mahruschow/team-pterodactyl/docs/README.md

# Team planning and handoff

## Team-name silkscreen update — October 21, 2026

Saadat Muyeen, Mahrus Chowdhury and Ryeed Zaman are now on the back silkscreen, with 2 mm text and 0.30 mm strokes. Fresh DRC, connectivity and schematic-parity checks report zero issues. All original PCB bytes are retained; only three text objects were added. The other eight Gerber layers match the prior geometry exactly, apart from export timestamps. Existing ERC evidence remains applicable to the unchanged schematic.

**Order the updated native PCB or fabrication ZIP. AISLER TCVOYNZG revision 1 is superseded and does not contain the names.** Two revision-upload attempts failed; the alternate upload form says an anonymous project is already in progress and requires login to save it. Sign in and upload the updated board, then inspect the bottom preview before ordering. No new AISLER revision or order has been created. Earlier statements below about revision 1 being the exact current PCB or ready for checkout refer to the previous checkpoint.

PCB bench holder: [CAD files and mounting instructions](../mechanical/pcb-holder/README.md) — STEP, printable STL, editable CadQuery source and preview. Uses the existing four mounting holes; physical fit remains unverified. This holder is separate from the future flight enclosure.

## First prototype scope and order checkpoint - October 21, 2026

**Current authority: [FIRST_PROTOTYPE_RELEASE.md](FIRST_PROTOTYPE_RELEASE.md).** PCB checks and AISLER upload/preview passed; project TCVOYNZG revision 1 is ready for checkout. FB1/SW1/SW2/J3 are selected for P1. The user explicitly excludes physical testing, flight qualification, subsequent redesign and casing from this phase; older statements requiring those before PCB fabrication are superseded. Assembly receipt/polarity checks remain part of building the prototype. No order placed. Updated known cost is USD 129.37 (15 price lines missing); entered mass 170.25 g (three missing). The provisional EUR board quote is separate.

**Current implementation — October 21:** Start with [RESUME_HERE.md](RESUME_HERE.md) and [COMPONENT_IMPLEMENTATION.md](COMPONENT_IMPLEMENTATION.md). Targeted component changes and the budget update are applied; fresh native checks pass. FB1 needs replacement and switch/header, harness, physical-fit and cold-test gates remain open. Earlier dated statements below are historical where superseded.

Start here when joining the project or resuming work. This directory contains the shared plan, current status, requirements, session notes and validation evidence. It travels with the repository; no previous chat or access to Saadat's computer is needed to read it.

## Reading order

Latest budget: [Power, cost and mass](POWER_COST_MASS_BUDGET.md) — lead's updated direction, checked calculations, source evidence, partial totals and battery-selection dependencies.

Latest PCB implementation: [GPS carrier integration](GPS_CARRIER_INTEGRATION.md) — all 51 footprints assigned and routed. Earlier missing-GPS entries below are historical.

**Meeting handoff:** [October 20 teammate meeting](TEAM_MEETING_2026-10-20.md) organizes completed work, outstanding tasks, team inputs, proposed owners and a decision log.

Latest implementation: [Sensor read validity](SENSOR_READ_VALIDITY.md) — checked sensor transfers/CRC, empty failed-data records, health/recovery behavior and sixteen host fault-test groups.

Previous firmware implementation: [Firmware reliability](FIRMWARE_RELIABILITY.md) — checked SD sessions/recovery, bounded BNO reset, cooldown, host failure tests and current build evidence.

Latest PCB implementation: [Layout review and cleanup](LAYOUT_REVIEW_CLEANUP.md) — ADC filter placement, I2C order, local ground stitching, readable silkscreen and validation.

Previous implementation: [Power routing](POWER_ROUTING.md) — regulator/5 V/sensor rails connected, test points relocated, fresh DRC and preservation evidence. GPS remains absent.

Previous implementation: [Regulator and GPS footprints](REGULATOR_GPS_FOOTPRINTS.md) — assigned regulator carrier, unassigned GPS comparison draft, source evidence, validation and remaining fit gates.

Read the [October 19 v4 design review](V4_DESIGN_REVIEW.md) for the historical independent checks, seven prioritized findings and Step 1–7 completion assessment. Hardware and firmware fixes remain open.

0. [What's done and what's left](REMAINING_WORK.md) — one-page progress table and to-do list by owner (lead, Saadat, teammate).
1. [Current status and resume checklist](CURRENT_STATUS.md) — where we stopped and the next concrete actions.
2. [Version-one requirements](V1_REQUIREMENTS.md) — agreed baseline, proposals and unresolved decisions.
3. [Development plan](DEVELOPMENT_PLAN.md) — the ten steps from imported baseline to tested hardware.
4. [October 18 session notes](sessions/2026-10-18.md) — work completed, decisions and limitations.
5. [Baseline review](BASELINE_REVIEW.md) and [native validation summary](validation/2026-10-18/VALIDATION_SUMMARY.md) — evidence behind the current issue list.
6. [Module connection and mechanical review](SENSOR_CONNECTION_MAP.md) — Step 3 pin map, power/pull-up review, footprint mismatch and remaining verification gates.
7. [Carrier footprint review](FOOTPRINT_REVIEW.md) — three native draft footprints, pad numbering, assembly assumptions and test evidence.

8. [Module assembly proposal and closure gates](MODULE_ASSEMBLY_PLAN.md) — candidate connectors, spacing calculation, symbol validation and M01–M04 evidence checklist.

9. [Teensy drawing comparison](TEENSY_MECHANICAL_REVIEW.md) — supplied PNG, matching nominal geometry, implemented SSW carrier and remaining fit/retention requirements.

10. [Open requests for the team lead](TEAM_LEAD_REQUESTS.md) — plain-language Steps 1–3 summary and the inputs needed to close Step 3 and approve placement.

11. [Placement and interference plan](PLACEMENT_AND_INTERFERENCE.md) — Step 4 draft floor plan, placement/routing rules, estimates and prototype test matrix.

12. [Power architecture and v4 schematic](POWER_ARCHITECTURE.md) — Step 5 legacy power findings, load budget, battery-agnostic architecture, schematic implementation and checks.

13. [v4 firmware](FIRMWARE_V4.md) — Step 6 logger behaviour, log formats, LEDs/controls, pinned build and what is untested.

14. [Draft v4 PCB layout](PCB_LAYOUT_V4.md) — Step 7 placement, ground planes, checks, render and what remains before routing sign-off.

## Directory contents

```text
docs/
  README.md                     Start here
  REMAINING_WORK.md             One-page progress and to-do list
  CURRENT_STATUS.md             Current handoff and next actions
  DEVELOPMENT_PLAN.md            Milestones and completion criteria
  V1_REQUIREMENTS.md             Requirements and decision register
  SENSOR_CONNECTION_MAP.md       Step 3 interfaces and mechanical review
  FOOTPRINT_REVIEW.md            Draft carrier library and approval gates
  MODULE_ASSEMBLY_PLAN.md        Connector/height proposal and closure record
  TEENSY_MECHANICAL_REVIEW.md    Teensy drawing comparison and carrier review
  TEAM_LEAD_REQUESTS.md          Inputs needed from the lead/team
  PLACEMENT_AND_INTERFERENCE.md  Step 4 floor plan, rules and test matrix
  POWER_ARCHITECTURE.md          Step 5 power design and v4 schematic record
  FIRMWARE_V4.md                 Step 6 firmware behaviour and build record
  PCB_LAYOUT_V4.md               Step 7 draft board record
  BASELINE_REVIEW.md             Repository/source/tool inventory
  sessions/
    2026-10-18.md                Session record
    2026-10-19.md                Step 4 session record
  reference/
    Budgets_2026-10-18.xlsx       Unchanged supplied parts workbook
    baseline_manifest_2026-10-18.json
    step3-source-manifest.json   Manufacturer CAD commits, URLs and hashes
    step3-cad-geometry.json      Extracted header/outline/hole coordinates
    step3-carrier-pad-map.csv    Carrier-to-manufacturer pad mapping
    step3-gps-cad-history.json   GPS CAD age/revision evidence
  validation/2026-10-18/
    VALIDATION_SUMMARY.md        Findings, triage and commands
    baseline-erc.json            Native schematic check report
    baseline-drc.json            Native PCB and parity check report
    schematic-netlist.xml        Native KiCad-exported netlist
    net-comparison.json         PCB/schematic pad-membership comparison
    step3-footprints/           Native coordinate check, fixture, DRC and SVGs
    step3-symbols/              Sensor pin-contract/GPS logical checks and SVGs
    step3-teensy/               Carrier check, positive/negative DRC fixtures and SVG
  validation/2026-10-19/
    step4-placement/            Draft placement fixture, separation checks, DRC and SVG
    step5-schematic/            v4 ERC, netlist comparison, BOM and PDF
    step6-firmware/             Teensy 4.1 build log
    step7-pcb/                  v4 board DRC/parity, separations, render and assembly PDF
```

## Keeping this handoff useful

- Update CURRENT_STATUS.md at the end of a work session: completed work, remaining issues, exact next action and tool limitations.
- Add a dated session note for substantial work. Record files changed, checks performed and decisions with their source. Use a suffix for multiple sessions on the same day if useful.
- Keep DEVELOPMENT_PLAN.md milestone status aligned with CURRENT_STATUS.md.
- Keep requirements and the D01-D10 decision register in V1_REQUIREMENTS.md. Distinguish team decisions from unapproved engineering proposals.
- Save new check reports in a dated validation directory and identify the source commit and KiCad version. Preserve previous reports for comparison.
- Follow the root README's branch and library rules. Do not commit editor lock files, local UI state, scratch copies or authentication data.
- Historical Gerbers and an audit report are not a fabrication approval. Do not infer a passing design from zero unconnected PCB items.

Historical paths and pre-commit statements in the baseline/session evidence describe that point in time. Use CURRENT_STATUS.md and Git history for the current state.
