mahruschow/team-pterodactyl/docs/validation/2026-10-21/first-prototype-release/drill-report.txt

Drill report for PTERODACTYL_v4.kicad_pcb
Created on 2026-10-21T18:14:28

Copper Layer Stackup:
    =============================================================
    L1 :  F.Cu                      front
    L2 :  In1.Cu                    in1
    L3 :  In2.Cu                    in2
    L4 :  B.Cu                      back

Drill file 'PTERODACTYL_v4-PTH.drl' contains
    plated through holes:
    =============================================================
    T1  0.300mm  0.0118"  (24 holes))
    T2  0.400mm  0.0157"  (1 hole)
    T3  0.710mm  0.0280"  (2 holes))
    T4  0.800mm  0.0315"  (41 holes))
    T5  0.850mm  0.0335"  (2 holes))
    T6  0.900mm  0.0354"  (8 holes))
    T7  1.000mm  0.0394"  (20 holes))
    T8  1.040mm  0.0409"  (75 holes))
    T9  1.100mm  0.0433"  (4 holes))
    T10  1.190mm  0.0469"  (4 holes))
    T11  1.500mm  0.0591"  (2 holes))

    Total plated holes count 183

Drill file 'PTERODACTYL_v4-NPTH.drl' contains
    unplated through holes:
    =============================================================
    T1  2.700mm  0.1063"  (10 holes))
    T2  3.200mm  0.1260"  (4 holes))

    Total unplated holes count 14
