mahruschow/team-pterodactyl/docs/sessions/2026-10-21.md

# October 21, 2026 — component research handoff

Saadat requested a fresh-chat handoff before continuing component finalization. The latest component research had not yet been saved or applied. Created RESUME_HERE.md and COMPONENT_FINALIZATION_RESEARCH.md, and refreshed the current documentation entry points.

Latest user direction: AISLER manufacturer; no spending cap; minimize practical mass without a hard mass ceiling; preserve current dimensions where compatible; choose battery/SD and exact components. Existing 3 h, -40 C, soldered sensor-header and no-telemetry requirements remain.

Research recommends four series Energizer L91 cells and Kingston SDCIT2/8GB industrial microSD. Pack holder/harness and cold runtime remain unresolved. Found -25 C JST-XH connectors unsuitable for a rated -40 C design; proposed Molex replacement requires a pitch/pad update. Proposed specific capacitors with corrected body outlines, AO3401A and other exact BOM candidates. See the research table for sources and confidence limits.

**No component-selection changes were applied to KiCad, firmware or the live workbook.** No new ERC/DRC run, physical test, purchase, commit or push occurred in this handoff. The previously uncommitted GPS/budget changes are preserved. Native schematic and PCB hashes were checked unchanged during this documentation update. Resume with the research and native-file inspection, then complete targeted edits and fresh validation.

## Component implementation continuation

Native v4 targeted edits are complete for the reviewed parts. 51 footprints / 246 segments / 25 vias retained; eight segments have bounded endpoint edits, four small nonmodule footprint moves, no changed pad nets. Fresh checks: 0 ERC, 0 enabled DRC, 0 unconnected, 0 parity; 32 nets and 35 no-connects verified. BOM: 47 individual reference rows, zero blank MPNs, four candidates (SW1, SW2, J3, FB1). Evidence is in `validation/2026-10-21/component-finalization/`.

L91 x4 with BH4AAW is the prototype pack candidate; Kingston SDCIT2/8GB is in the budget. Updated model: 1.618 W average, 3.568 W peak, 8.669 Wh provisional nameplate target for 3 h. Entered mass 170.25 g with three missing mass lines; known price $118.30 with 16 unpriced lines. Detailed path-loss screening flags startup risk at a 4 V loaded pack. No physical validation or purchasing occurred.

The following entries preserve prior checkpoints and are superseded by COMPONENT_IMPLEMENTATION.md where they conflict.

See COMPONENT_IMPLEMENTATION.md and current RESUME_HERE.md for applied changes and next gates. Battery holder rating resolved to BH4AAW candidate; complete pack/harness remains unqualified. No commit, push, purchase or external message.

## First prototype order checkpoint

User explicitly limited this phase to the first physical prototype: no cold/flight testing or subsequent revision gate before fabrication. Read FIRST_PROTOTYPE_RELEASE.md and updated RESUME_HERE.md. The four held board references were resolved, fresh checks passed, original routing/outline/module positions retained, and manufacturing exports audited against native drills. AISLER TCVOYNZG revision 1 successfully processed the saved board; top/bottom preview checked and 3 bare boards configured at 1.6 mm / 35 um / ENIG / green-white. Provisional anonymous quote EUR 51.37 net; account/shipping/tax/payment remain. Nothing ordered, committed or pushed. New evidence lives in validation/2026-10-21/first-prototype-release. Separate grouped board/offboard BOMs and assembly instructions cover one populated prototype. Budget updated to USD 129.37 known subtotal (still incomplete); PCB quote kept separately in EUR.

## Git publication checkpoint

User authorized committing all project work to saadat-dev, pushing it, then updating main. Collected the native design, local footprints, documentation, scripts, validation evidence, reviewed fabrication ZIP and current budget workbook. Scratch checkpoints/downloads and Python caches remain local and ignored. Added exact-byte Git attributes for the four validated native files so their recorded SHA-256 values survive checkout. No design or firmware change was made during publication. Check Git history and remote refs for completed push status.

## Optional PCB holder

At the user's separate request, created an open bench holder using the native H1-H4 positions: 90.17 mm spacing, 105.79 x 105.79 x 13 mm overall holder, 10 mm clearance above its 3 mm frame. STEP/STL, simplified reference-board assembly, editable CadQuery source, preview, geometry checks and hardware instructions are in mechanical/pcb-holder/. Single-solid STEP reimport and closed single-body STL checks passed; physical fit and full component/hardware clearance are not established. The user authorized pushing the holder to main. The PCB and firmware are unchanged.

## Team-name silkscreen update — October 21, 2026

Saadat Muyeen, Mahrus Chowdhury and Ryeed Zaman are now on the back silkscreen, with 2 mm text and 0.30 mm strokes. Fresh DRC, connectivity and schematic-parity checks report zero issues. All original PCB bytes are retained; only three text objects were added. The other eight Gerber layers match the prior geometry exactly, apart from export timestamps. Existing ERC evidence remains applicable to the unchanged schematic.

**Order the updated native PCB or fabrication ZIP. AISLER TCVOYNZG revision 1 is superseded and does not contain the names.** Two revision-upload attempts failed; the alternate upload form says an anonymous project is already in progress and requires login to save it. Sign in and upload the updated board, then inspect the bottom preview before ordering. No new AISLER revision or order has been created. Earlier statements below about revision 1 being the exact current PCB or ready for checkout refer to the previous checkpoint.
