mahruschow/team-pterodactyl/docs/sessions/2026-10-20.md

# October 20, 2026 — firmware SD and BNO reset recovery

Continued the authorized firmware reliability work after interruption, starting
from `e1663f7` on `saadat-dev`. The interrupted work had added storage source and
a local BNO library patch, but had not integrated or validated them.

- Integrated transactional required-file session creation, checked writes/syncs,
  best-effort close, retry in a fresh folder and persistent fault indication.
- Moved metadata writing into a separately checked function. Appended
  `storage_fault_total` to health rows and USB diagnostics; version 4.0.1-draft.
- Vendored Adafruit BNO055 1.6.4 with its license, bounded post-reset polling,
  reset-write/read checks and one enum conversion fix for the host compiler.
- Added IMU retry cooldown and `INIT_WAIT` rows; refreshed loop timestamps after
  blocking operations to avoid premature SD retry due to unsigned subtraction.
- Added host fault-injection tests against production code and updated current
  status, remaining work and the October 20 meeting handoff.

See [FIRMWARE_RELIABILITY.md](../FIRMWARE_RELIABILITY.md) and its dated validation
folder for commands/results/limits. Sensor transfer/CRC validity and GPS RMC
freshness remain open. No PCB edits, firmware upload or hardware tests.

## Sensor transfer/CRC follow-up after 5a22f0b

Saadat authorized the next step. Implemented checked BNO055 sample getters and
initialization writes, vendored MS8607 1.0.4 with its attribution/license notices,
and propagated reset, calibration PROM/CRC, configuration, conversion and
humidity-transfer/CRC failures. The logger leaves failed rows empty, updates
sensor health and recovers on successful sampling without reinitializing every
transient read failure. Five consecutive IMU failures still trigger reset.

The suite now compiles both actual drivers; the old fake MS8607 driver was removed.
Sixteen groups pass, including invalid-data rows, health/LED behavior, short reads,
CRC rejection, initialization faults, wrapper reuse, recovery and earlier SD/BNO
timeout regressions. Teensy build passes with zero warnings. Firmware is
4.0.2-draft. See SENSOR_READ_VALIDITY.md and the dated sensor-read-validity evidence.
GPS freshness and CSV analysis are next; no PCB changes or hardware tests.

## GPS footprint integration

**U5 is assigned, placed and routed in the current v4 board.** Saadat inspected the linked 2017 Adafruit CAD and reported that it is the same, authorizing use of the existing source-derived carrier geometry. This is user visual acceptance for integration, not manufacturer confirmation or a measured physical-fit result.

See [GPS_CARRIER_INTEGRATION.md](../GPS_CARRIER_INTEGRATION.md) for changes, complete zero-error check results and remaining fit/fabrication work. Existing 50 footprints and all routing were preserved; added U5, 13 segments and eight vias. Firmware unchanged. Reload the open KiCad board without saving its stale contents.

## Power, cost and mass budget follow-up

Saadat supplied the lead's instruction to prepare all three budgets and choose a battery; nothing is ordered and the package should be as small as functional. Read `New Budgets.xlsx` unchanged and recorded its SHA-256. It is a different payload's reference, so its pumps/heaters, two-hour requirement, 37 Wh pack and owned-part costs were not adopted.

Created a live three-sheet logger budget and reproducible builder, with manufacturer sources, explicit current/efficiency/mass allowances, incomplete-total guards and runtime scenarios. Calculated 1.494828 W average / 3.283791 W peak battery input; illustrative four-hour nameplate target 10.677339 Wh. Five module prices total $118.30, with 17 cost lines missing. Mixed published/estimated mass subtotal is 107.7 g, excluding three missing mass inputs. The 0.7 A PTC needs review against low-voltage input peaks and its trip/temperature curves.

Twenty-two baseline, perturbation, missing-input, zero-efficiency and restoration checks passed; no final formula errors. Rendered all sheets and source notes. Runtime/battery fields were restored to blank. Added POWER_COST_MASS_BUDGET.md and validation/2026-10-20/budget-check.json, updated handoff/requirements/team-request pages. No PCB or firmware edits in this budget follow-up; no export, purchase, commit or push. Next: team duration/temperature, SD selection, battery/power-path review and complete BOM quotes/masses before compact mechanical design.

## Confirmed runtime update

Saadat confirmed runtime is three hours. Recorded this as total powered operation in the live budget and creation source, requirements and handoff pages. Recalculation gives 4.484483 Wh consumption and 8.008005 Wh nameplate target with the existing proposed reserve/usable-energy assumptions. Checked the Power and summary target match and rendered the updated summary. Temperature, battery voltage/selection and PTC review remain open. No commit or push.

## Temperature and through-hole assembly decisions

Lead's -40 C battery minimum replaces the earlier -45 C screening assumption. Saadat confirms through-hole soldered sensors and custom casing CAD after the PCB layout is complete. Recorded soldered headers at breakout/carrier holes; exact header lengths, pin/drill fit, underside clearance and retention are still open. Existing sensor sockets/12 mm stack proposal is historical. Teensy/regulator mounting unchanged. Updated the live workbook and builder: temperature input -40 C; interconnect mass now missing instead of the obsolete 10.5 g socket allowance; partial mass 97.2 g with four missing lines. Checked these outputs and unchanged 8.008005 Wh energy target, and rendered affected regions. No PCB/firmware edits, battery selection, commit or push.
