mahruschow/team-pterodactyl/docs/sessions/2026-10-19.md

# Session notes — October 19, 2026

## Session scope

Continued on `saadat-dev` after commit 65b851e, which published the Step 3 draft package. Saadat asked whether Step 3 could be finished, then asked for a plain-language summary of Steps 1–3 and a list of inputs to request from the team lead, saved in the docs. After that, the work moved on to Step 4.

## Work completed

1. Rechecked public sources for exact PA1616D #5440 geometry: the product page, the Ultimate GPS guide downloads page, and the Adafruit-Ultimate-GPS and Adafruit_CAD_Parts repositories. The product page confirms the 34.2 × 25.3 × 11.4 mm envelope and the September 18, 2024 revision that added the coin-cell holder. The guide's fab prints and board files still cover only the v3/PA6H, USB Micro B and USB-C variants. No #5440 entry exists in the CAD parts listing. M01 cannot be closed from public sources. M02–M04 need the enclosure, hardware approval and physical parts.
2. Added TEAM_LEAD_REQUESTS.md. It holds a plain-language Steps 1–3 summary, Step 3 closure requests R1–R5, Step 4 placement requests R6–R9, Step 5 inputs and an answer log.
3. Step 4: inspected the legacy board read-only (97.79 mm square outline, four 3.302 mm holes 3.81 mm from each corner, 4 copper layers, 1.6 mm thick). Drafted a floor plan and wrote PLACEMENT_AND_INTERFERENCE.md: assumptions A1–A6, placement/routing rules PC1–PC15, magnetic-field and I2C bus/rise-time estimates, and test matrix T1–T11 with proposed pass criteria.
4. Added tools/build_placement_fixture.py. It copies only the legacy outline and holes into an isolated fixture, places the three draft carrier footprints and two planning boxes (GPS envelope, power region), runs native DRC and checks 17 edge, hole and separation rules. The first run found a real issue: the MS8607 reference text was clipped by the board edge. Moved the module 2 mm down. The final run passes all 17 checks with zero DRC violations and zero unconnected items. The PDF export was visually inspected, and overlapping placeholder labels were fixed.

## Findings worth sharing

- Routing supply current with its return directly beneath it matters more than distance for the BNO055. An unpaired 0.3 A conductor at 40 mm is about 1.5 µT (about 5 magnetometer resolution steps); paired over a plane it is under 0.01 µT.
- Estimated I2C rise time with only the two host-side 10 kΩ pull-ups is about 340 ns at about 80 pF. That is fine for 100 kHz but over the 300 ns fast-mode limit, so do not use 400 kHz without measuring.
- A sealed enclosure would give wrong MS8607 pressure readings. Outside-air temperature/humidity needs exposure; remote probes were excluded in D01.
- The GPS needs a sky-facing antenna and an RF-transparent lid. Flight orientation of the board is an open question (R6).

## What was not done

- No edits to the main schematic, PCB, imported libraries or firmware. No routing.
- No physical tests, measurements or purchases. No messages sent to the lead or Adafruit.
- Separation targets and pass criteria are proposals pending team review.

## Resume point

Use CURRENT_STATUS.md. Step 3 remains open at M01–M04. Step 4 is drafted for review. The next independent work is Step 5 power architecture and schematic, using PC6, PC11, PC13 and PC14, while lead answers R1–R9 are pending.

## Step 5 — power architecture and draft v4 schematic

Saadat asked to move on to Step 5.

1. Traced the legacy power design from the exported netlist (read-only). Findings F1–F6 in POWER_ARCHITECTURE.md:
   - Two regulator outputs are switched straight onto VCC with no OR-ing.
   - Nothing isolates Teensy VIN from USB power.
   - The status LEDs have no series resistors.
   - The voltage monitor reads regulated 5 V, not the battery.
   - There is no fuse or reverse protection.
   - The A17 net's purpose is unknown.
2. Confirmed Teensy 4.1 limits on the PJRC page: pins not 5 V tolerant, 4 mA per-pin recommendation, 250 mA external 3.3 V, cut the VUSB/VIN pads for external power. Confirmed the Pololu S9V11F5 page: 2–16 V in, 5 V out, 1.5 A, no reverse protection, EN pull-up. The S9V11F5 physical pinout was not confirmed.
3. Wrote the load budget (about 175 mA typical / 260 mA peak at 5 V; about 1 W from the battery) and the proposed architecture. Asked three questions. Saadat chose the battery-agnostic regulator, dropping the expansion headers, and a new clean schematic.
4. Built `Native_KiCad_v4/`:
   - `tools/generate_v4_schematic.py` writes the schematic, a v4 symbol library (logical regulator, Teensy with corrected power pin types) and project library tables. The tables use `${KICAD10_*}` paths, because this machine has no global KiCad library table.
   - `tools/sexpr.py` is a small S-expression helper.
   - Two design changes were made while building: the main switch became an off-board panel switch on a connector (the library slide switches are rated about 100 mA), and the LED colours changed to low-Vf types with 680 Ω resistors (white/blue would barely light from 3.3 V).
5. `tools/verify_v4_schematic.py`:
   - The first ERC showed only library-path and pin-type warnings; both were fixed. Final: ERC 0 violations at all severities.
   - The netlist matches a separately written expected list (32 nets, 36 intentional no-connects).
   - Footprint presence is checked, and the BOM and PDF are exported.
   - The PDF was visually inspected and the layout tidied twice to remove overlaps.

Not done: no v4 PCB, no regulator or GPS footprint, no part-rating confirmation, no simulation or hardware test. The imported v3.8 project, the Step 3 libraries and their evidence hashes are unchanged.

## Step 6 — v4 firmware

Saadat asked to continue with Step 6 and then Step 7.

1. Extracted v19.1 to scratch storage and read it. It depends on u-blox UBX, XBee, OLED, LSM9DS1, MS5611, thermistors and the heater, and it waits for interactive input at startup. Decided to write a new sketch for the v4 pins instead of porting it; the archives are unchanged.
2. With Saadat's permission, installed the Teensy platform 1.62.0 (PJRC index) and Adafruit BNO055 1.6.4, MS8607 1.0.4, GPS 1.9.0, Unified Sensor 1.1.15 and BusIO 1.17.4 using the IDE's bundled arduino-cli 0.35.3. No persistent CLI or IDE settings were changed; the board URL was passed per command.
3. Checked the library sources: the BNO055 gyro reads in deg/s (converted to rad/s), MS8607 pressure in hPa (converted to Pa), and the GPS parser accepts `$GN` talkers.
4. Wrote `Firmware_v4/PTERODACTYL_v4` (config.h, .ino, sketch.yaml, README) and docs/FIRMWARE_V4.md.
   - A script check confirmed every record format has the same field count as its CSV header.
   - Review fixed an SD-retry timer that would have logged false overruns.
   - Two format-truncation warnings were fixed by enlarging buffers.
5. Final compile for Teensy 4.1: 0 warnings, 113 KB code. The build log is saved under validation/2026-10-19/step6-firmware.

Not done: no hardware run, no bench timing or SD power-loss tests, no log-checking script. The `--profile` isolated build was not run, because it downloads its own copies of the platform and libraries.

## Step 7 — draft v4 PCB placement

1. Measured every footprint's courtyard, then wrote `tools/build_v4_pcb.py` (KiCad Python):
   - Reads the KiCad-exported v4 netlist and copies the legacy outline and hole positions.
   - Creates 4 layers with In1/In2 GND planes.
   - Loads each footprint, assigns nets, copies the schematic fields and DNP/BOM flags, and links each footprint to its symbol.
   - Places parts from a table that follows the Step 4 floor plan. U2 and U5 are drawn as keep-out envelopes.
2. Iterated with DRC:
   - The first pass showed silkscreen overlaps and 59 field/attribute parity differences.
   - Fixed by copying the fields, matching the test points' BOM exclusion, hiding the mounting-hole references and moving references to F.Fab.
   - Final: DRC 0 violations; parity only the missing U2/U5; 57 unconnected because nothing is routed.
3. Added `tools/check_v4_pcb.py`. It re-measures PC1–PC5 on the real placement (all met; the closest is GPS ↔ power at 20.7 mm against 20 mm), renders the top view and exports an assembly PDF. The render was inspected.
4. Wrote docs/PCB_LAYOUT_V4.md and updated the status, plan and indexes.

Java 17 is installed, so Freerouting is possible, but it was not downloaded. Routing is not done.

## Step 7 — autoroute attempt and remaining-work checklist

1. Committed and pushed Steps 6–7 as d17e3c7 at Saadat's request.
2. Downloaded the Freerouting 2.5.0 Windows CLI (official GitHub release; SHA-256 matched the release checksums file) into scratch storage; it is not in the repository.
3. Before routing:
   - Added Default/Power net classes to the project file through the schematic generator.
   - Made the U2/U5 envelopes keep out tracks and vias on the outer layers.
   - Fixed the generator's non-deterministic ordering of unused Teensy pins (same connections, now stable output).
   - Rebuilt the unrouted board.
4. Ran `tools/autoroute_v4_pcb.py`. Freerouting's routing thread crashed at once (native-image serialization error), and the process sat idle for about 22 minutes until it was stopped. The board was unchanged, and the log was saved. The CLI also attempted anonymous analytics, which was blocked with a 403.
5. Hardened the script: early crash detection, analytics disabled, `.jar` + Java path supported. Freerouting 2.5.0's `.jar` targets Java 25; only Java 17 is installed.
6. Added routing metrics to `tools/check_v4_pcb.py`.
7. At Saadat's request, wrote docs/REMAINING_WORK.md: a one-page progress table and a to-do list by owner (lead, Saadat, teammate), linked from the indexes and CURRENT_STATUS.

Not done: the board is still unrouted.

## Step 7 — first-pass autoroute

1. Committed and pushed the checklist round as 2a2bbfc at Saadat's request.
2. With Saadat's approval, downloaded two files and verified both. Both live in scratch storage; nothing is installed or committed.
   - The Eclipse Temurin JRE 25.0.4.1 Windows zip; its SHA-256 matched the Adoptium API.
   - `freerouting-2.5.0.jar`; its SHA-256 matched GitHub's release-asset digest.
3. Iterated the router setup:
   - The first jar run routed everything but ran tracks on the inner GND planes. Fixed by marking In1/In2 as power planes with a no-tracks rule area.
   - Freerouting then refused vias, and the Teensy's parts-only area was exported as a pin-covering keep-out.
   - Fixed in a router-only DSN copy, exported in a separate process because KiCad Python holds one board per process. It shrinks those two areas, adds board-edge keep-out strips and disables neck-down.
   - Added a 0.3 mm Supply3V3 class.
4. Result:
   - DRC 0 violations; parity only U2/U5; separations met.
   - 192 segments / 10 vias on the outer layers only; I2C 110.5 mm.
   - 6 supply connections are open. Freerouting oscillated between 6 and 10 unrouted, caused by the test-point row above the Teensy.
   - `check_v4_pcb.py` now also rejects inner-plane tracks and exports a copper PDF.
5. Documented the attempts, the result and a hand clean-up list in PCB_LAYOUT_V4.md, and updated REMAINING_WORK.md and CURRENT_STATUS.md.

## Independent v4 review and documentation publication

Saadat requested a review of the side work through Steps 1–7, then authorized committing and pushing the documentation to `saadat-dev`. Reviewed source: `8933189`.

- Added [V4_DESIGN_REVIEW.md](../V4_DESIGN_REVIEW.md): seven prioritized findings, recommended fixes and an assessment of each step.
- Preserved fresh ERC, refilled DRC/parity, actual-board geometry inspection and firmware build evidence under `validation/2026-10-19/v4-design-review/`.
- Confirmed 0 ERC violations, 0 enabled physical DRC violations, 10 unconnected items and two missing footprints (U2/U5). Actual separation targets pass; the Teensy firmware builds with the installed documented dependencies.
- Added the unresolved findings to the remaining-work checklist and linked the review from the handoff entry points.
- No schematic, PCB, firmware or tooling fixes are included. No hardware testing was performed. Next work is to close the review findings and existing team/mechanical decisions before sign-off.

## Regulator carrier integration and GPS draft

- At Saadat's request, created both carrier footprints. U2 uses the official Pololu geometry/pinout; GPS uses the recorded legacy Adafruit CAD and is named/marked UNVERIFIED.
- Assigned and placed U2, changed its carrier symbol to VIN/GND/VOUT only, and removed the former EN no-connect. GPS stays unassigned pending M01.
- Preserved all 192 existing track segments, 10 vias and the other 49 footprints; refreshed inner-plane fill. Regulator VIN/VOUT are not routed by this change.
- Corrected the placement checker to use current PCB geometry; its in-memory moved-IMU regression fails PC1 as intended.
- Native checks: 0 ERC, 0 enabled physical DRC, only U5 missing, 12 unconnected items; source geometry and 32-net/35-no-connect checks pass. No firmware change or hardware test.
- See [REGULATOR_GPS_FOOTPRINTS.md](../REGULATOR_GPS_FOOTPRINTS.md) for source hashes, reproduction, assembly limits and next steps. Changes are prepared locally; no new commit/push was made during this footprint work.

## Published footprint checkpoint and completed power routing

At Saadat's request, committed and pushed the footprint work as `d40fba3` to `origin/saadat-dev`, then continued the remaining power routing.

- Connected regulator VIN/VOUT, all present +5V and SENSOR_3V3 pads, and decoupling/test points. Added 37 outer-layer power segments with no new vias.
- Moved TP1/TP2 to the power region and TP4 beside the sensor rail. Removed five unloaded TP1 spur segments totaling 68.667 mm; retained the actual power-current paths.
- Preserved 197 prior track/via objects exactly and 47 footprint positions/pads. Only the three named test points moved; their pad/net identities stayed the same. Schematic, symbol library and project design rules are unchanged.
- Fresh refilled native DRC: 0 enabled physical violations, 0 unconnected items for the 50 placed footprints; parity still reports U5 missing. GPS is not implemented by this result.
- All seven placement separations pass; I2C remains 110.5 mm. Power track widths meet the existing 0.5/0.3 mm classes. No inner-plane tracks or GPS-envelope intrusions. Copper and In2 return-plane SVGs were visually reviewed.
- Current evidence and remaining work: [POWER_ROUTING.md](../POWER_ROUTING.md), `validation/2026-10-19/power-routing/`. No firmware edits or hardware tests. GPS M01, final layout/mechanical/manufacturer review and firmware reliability findings remain open.

## Layout review and targeted cleanup after 46f926a

Saadat authorized the next layout-review pass and asked to continue it.

- Moved C2 from beside the power section to within 4.493 mm of Teensy carrier pin 26. Moved TP3/TP5 and locally adjusted +3V3 and BTN_USER traces for clearance; removed the old C2 branch.
- Corrected I2C from host → IMU → environment to host → environment → IMU. New topology checks reject the previous copper order. SDA is 135.163 mm and SCL 128.209 mm, both under the 150 mm proposal.
- Added four I2C signal vias and three nearby GND stitching vias connecting both inner planes. Optional outer pours remain deferred pending GPS. No inner-plane tracks added.
- Added readable F.Silkscreen references, module/control labels, battery polarity and a test-point key; hid overlapping value fields without changing stored values.
- Refined the placement checker: C2 is an ADC filter governed by PC13's proximity check, rather than a converter/current-source member of the 40 mm power group. Actual power-source separations and project design rules are unchanged.
- Native DRC: 0 enabled physical violations, 0 unconnected items for present footprints, only U5 missing. Preserved 220 existing track/via objects and 47 footprint placements; source schematic/project/symbols, outline, zone boundaries and stackup unchanged.
- Added tools/verify_v4_layout.py and current evidence under validation/2026-10-19/layout-review. Visual copper review complete. See LAYOUT_REVIEW_CLEANUP.md for remaining GPS, power-integrity, assembly/manufacturer and hardware-test gates. No firmware changes or hardware tests.

## October 20 teammate meeting preparation

Prepared TEAM_MEETING_2026-10-20.md from design commit f55657f, with completed deliverables, prioritized remaining work, required team/lead inputs, a proposed responsibility split, a 40-minute agenda and blank decision/owner fields. Reconciled REMAINING_WORK.md and stale lead-request descriptions so they no longer report U2 or present power routing as unfinished. Clearly separated implemented/digitally checked work from hardware validation and fabrication approval. No hardware, firmware or design changes; no questions sent externally and no owners or purchasing decisions assumed approved.
