mahruschow/team-pterodactyl/docs/sessions/2026-10-18.md

# Session notes — October 18, 2026

## Session scope

Saadat supplied a prior-chat handoff, a partner's shared chat, the lead's sensor email, the actual Budgets.xlsx workbook, and later the lead's no-telemetry clarification. Work focused on establishing a local baseline and a concrete development plan. The final request was to preserve the work for teammates/future sessions and commit/push it to `saadat-dev`.

Starting source commit: `69450d2df193a769bd69af3dae057a2e1a04c28a` (imported KiCad baseline). The repository was clean before this session's additions. A final pre-commit fetch confirmed the local branch and `origin/saadat-dev` matched. The commit containing this note records the handoff publication; use Git history for its hash and the remote branch for publication state.

## Work completed

1. Read the prior handoff and partner's shared chat, then the local README and design brief. Located the repository in OneDrive Documents and confirmed the existing `saadat-dev` branch. Initial Git access restrictions were resolved when local permissions changed.
2. Read the supplied XLSX directly, including cell notes, formulas, cached results and product links. Preserved it byte-for-byte in docs/reference and independently checked the budget arithmetic. Confirmed the four selected modules. Recorded that SD draw/regulator losses are excluded, mass/current estimates remain provisional, and the board row's $30 value conflicts with its $4.50 Perma-Proto note. No workbook cells were edited.
3. Inventoried project files and local libraries: 39 PCB footprints, 33 local footprint files, 417 segments, zero vias and two zones. All namespaced PCB footprints resolved to local files. Both firmware ZIPs passed CRC checks. Saved hashes for the main native files.
4. Located KiCad 10.0.7 after Saadat installed it. Ran fresh ERC and physical DRC, with zone refill and schematic parity, on a temporary project copy. Saved the native JSON reports and an exported schematic netlist.
5. Triaged findings: 33 schematic errors/10 warnings; 11 physical DRC errors/428 warnings; 0 unconnected items; 52 additional parity warnings. Compared assigned PCB net pad membership with the KiCad-exported netlist. All 50 assigned PCB nets matched membership, allowing VCC_2/VCC_3/N$14 naming differences. The 52 warnings remain unresolved, and physical/module correctness is not established by this comparison.
6. Verified all 41 original native-project/library/report files remained unchanged during the audit. No design corrections were attempted.
7. Created a ten-step development plan, an interference review/test matrix, and a Step 2 requirements draft with optional-feature inventory, proposed sampling/logging behavior, acceptance checks and a decision register.
8. Read relevant v19.1 firmware sections. Found that GPS configuration changes the shared sensor update delay, startup includes interactive waits, logging batches ten data rows, and legacy OLED/thermistor/XBee/heater functionality needs deliberate retention/removal decisions. These were source observations, not a runtime test.
9. Applied the lead's clarification supplied by Saadat: no telemetry; store data locally for analysis after landing. Updated requirements, plan, README and design brief to exclude radio-only implementation work. Kept interference/spacing explicit.
10. Organized docs/ with a start-here index, current status/resume instructions, this session note, the existing plan/requirements, the source workbook and validation evidence.

## Confirmed direction versus proposals

Confirmed working direction: Teensy 4.1; BNO055 2472; MS8607 4716; PA1616D 5440; local microSD logging; no telemetry; interference-aware layout and testing.

Proposals only: 10 Hz motion/orientation/magnetic recording; 1 Hz environment/GPS/health; automatic startup; independent sensor schedules; four-hour bench endurance scenario; exact user-control/indicator arrangements. Battery, mission/environment limits, enclosure, manufacturer, measurement accuracy/bandwidth and remaining optional features are unresolved. The workbook's three-hour duration remains a planning input.

## What was not done

- No schematic, PCB, symbol, footprint or firmware edits.
- No implemented radio removal or new sensor wiring/footprints.
- No detailed manufacturer-verified connection map or mechanical footprint review.
- No fresh 3D/mechanical inspection, interference measurements or bench/hardware tests.
- No Teensy toolchain setup, firmware compilation or dependency pinning.
- No fabrication package, orders, main-branch merge or messages to the lead/teammate.

## Files added or updated

Added docs/README.md, CURRENT_STATUS.md, DEVELOPMENT_PLAN.md, V1_REQUIREMENTS.md, BASELINE_REVIEW.md, this session note, the workbook/hash inventory under reference/, and the native validation summary/reports/netlist/comparison under validation/2026-10-18/.

Updated root README.md and CUSTOM_BOARD_BRIEF.md with the selected sensor baseline, local-only logging decision, interference requirement, fresh check counts and links to the shared documentation.

## Resume point

Use [CURRENT_STATUS.md](../CURRENT_STATUS.md). Step 1 is complete; Step 2 is a documented draft with open decisions; next independent engineering work is Step 3's exact module interfaces, power mapping and mechanical verification. Do not rerun the unchanged baseline checks just to recreate the same reports unless files, settings or tool versions have changed or a result needs investigation.

## Continuation after handoff publication

The handoff was committed and pushed to `saadat-dev` as `2632585`. Saadat then requested continuing Step 2. The branch was clean when this continuation began.

Reviewed the requirements and added a focused working review within V1_REQUIREMENTS.md: priority feature/power/measurement decisions, measurement-purpose prompts, an unsent team brief, and a completion checklist distinguishing documentation readiness from requirements freeze. Updated CURRENT_STATUS.md to reflect the active Step 2 focus. Asked Saadat to select a feature package and supply any known battery, total powered duration and measurement priorities. Answers remain pending; no new requirements were approved and no hardware or firmware changes were made.

### Step 2 answers received

Saadat subsequently selected **core logger with power control, status LEDs and supply monitoring**. Updated D01 and the feature table accordingly: OLED, remote probes, alternative IMU, heater and servos are excluded from core scope. Exact power/stop controls and the legacy pull-before-flight role remain open; a feature-package answer is not approval of a specific circuit.

Saadat reaffirmed gyro, accelerometer, GPS, pressure, temperature and altitude measurements and explained that his role is mainly PCB design. Battery and flight/runtime information are unknown to him. The supplied measurement list is sufficient to continue interface work; numerical ranges, accuracy and timing targets remain lead/team inputs. Humidity stays in the working selection from MS8607. Updated requirements, status, development plan, root README and design brief to reflect the answers. Step 3 can proceed while these dependencies remain visible; full requirements freeze is still open. No hardware or firmware edits or physical tests were performed.

### Step 3 source and connection review

At Saadat's request, checked official PJRC and Adafruit interface documentation and downloaded manufacturer Eagle board/schematic files at pinned Git commits into scratch storage. Extracted transformed header coordinates, outline segments and mounting holes; saved portable source/hash and geometry evidence under docs/reference. Compared the imported BNO055/Teensy footprint pads and native schematic net membership with the sources.

Created SENSOR_CONNECTION_MAP.md with per-pin dispositions, Teensy Wire 18/19 and Serial2 7/8 mapping, I2C addresses (0x28, 0x40, 0x76), 3.3 V VIN proposal, pull-up analysis, power worksheet and mechanical gates. Found imported BNO055 pads correspond to the QT layout and its 3Vo position, incompatible with the selected older #2472. Saadat confirmed boards are not purchased and instructed use of the exact spreadsheet product numbers, resolving the intended non-QT BNO055 family. Published Ultimate GPS CAD names PA6H; exact #5440 mechanical approval is still open. Teensy complete mechanical comparison, carrier footprint creation and physical fit remain outstanding. No native design changes, firmware build or hardware tests performed. Do not call Step 3 fully complete.

### Step 3 continuation — native carrier footprints

Created the project-local Pterodactyl_Modules.pretty library with BNO055 #2472 and MS8607 #4716 carrier footprints, registered through `${KIPRJMOD}` in fp-lib-table. Added generator and independent KiCad-native coordinate checker under tools/, pad mapping CSV, attribution/license and FOOTPRINT_REVIEW.md. Pads include VIN separately from the breakout regulator output; mounting centers and module outline curves derive from the pinned manufacturer CAD. Header drill/pad dimensions, carrier fastener holes, screw envelopes and courtyard margins are explicit provisional assembly choices.

KiCad 10.0.7 loaded both footprints. Checks passed for all 15 numbered pads and eight mounting centers against the source data. Exported native SVG previews, inspected renders and adjusted an overlapping drawing annotation. A separate unrouted fixture DRC found zero violations; saved fixture/report/SVGs and coordinate evidence under validation/2026-10-18/step3-footprints. Fixture has no circuit nets and is not a fabrication source. Main schematic/PCB, imported library footprints and firmware remain unchanged.

Checked the official Ultimate GPS repository branches and board-file history: only master found; last board-file change November 12, 2017, with PA6H still named. No #5440 entry was found in the inspected Adafruit CAD-parts top-level listing. This does not establish exact PA1616D mechanics. Browser access to PJRC's dimension drawing was denied by browser security policy; did not attempt to bypass that denial. Full Teensy drawing comparison remains open. Updated status and plan; Step 3 still needs GPS/Teensy mechanics, mounting hardware/height and physical fit. No commit or push performed during this continuation.

### Publication requested

Saadat then requested committing and pushing this work to `saadat-dev`. A fresh fetch confirmed the branch matched its remote before publication. The publication includes Step 2 scope decisions, Step 3 connection/mechanical research, two draft carrier footprints and library registration, generators, source provenance and validation evidence. Added scoped LF attributes for the footprint files and source geometry so Windows checkout conversion does not invalidate their recorded SHA-256 hashes. Main schematic/PCB and firmware remain unchanged. The commit containing this note identifies the publication; consult Git history for its hash.

### Step 3 continuation — symbols and concrete assembly proposal

Continued after publication commit 472bcfc on saadat-dev. Added project-local BNO055 #2472/MS8607 #4716 symbols with default carrier footprints and explicit electrical pin types; registered through sym-lib-table. Added reproducible symbol generator and independent pin-contract checker. KiCad 10.0.7 exported both symbols; visual review and all 15 pin/function/type/CSV/native-footprint-number checks passed. No main schematic, PCB, imported library or firmware edits.

Read Samtec SSW/TSW/HTSW official catalog drawings and rendered the SSW single-row footprint drawing. MODULE_ASSEMBLY_PLAN.md proposes three configured sensor connector pairs, 12 mm board separation, and insulating M2 retention envelopes. Calculated nominal engagement is 4.89 mm; tolerance stack, exact fastener parts, stock/cost and physical fit are not approved. Changed both carrier socket drills from provisional 1.0 mm to drawing-based 1.04 mm; retained 1.8 mm pads. Refreshed source-coordinate evidence, native previews and isolated fixture: all 15 pads/eight mounting centers passed and DRC again found zero violations/zero unconnected items. This is not circuit validation.

Saadat explicitly allowed retrying the official PJRC Teensy drawing. Browser policy still denied network authority because a saved permission or managed policy blocks the origin. Did not bypass that restriction. Exact #5440 geometry remains unverified. Added M01–M04 evidence/owner/gate checklist, physical measurement record and an unsent manufacturer question. Step 4 interference planning can proceed with draft envelopes; Step 3 mechanical sign-off is still open. No inquiry, purchase, commit or push performed in this continuation.

### PJRC drawing supplied locally — Teensy comparison completed

Saadat supplied dimensions_teensy41.png directly. Preserved the exact PNG under docs/reference and its SHA-256 in teensy-dimension-check.json. This closes the missing-drawing dependency without any network retry. KiCad-native measurement confirms two rows of 24 pads, 2.54 mm pitch, 15.24 mm row separation, 1.27 mm nominal end margins and the 60.96 × 17.78 mm outline. Main PCB instance U$3 matches the imported library pads after in-memory coordinate normalization.

Recorded remaining issues in TEENSY_MECHANICAL_REVIEW.md: 47 drills at 0.85 mm and pin 10 at 0.90 mm need exact connector-tail approval; all 232 graphics are silkscreen with no courtyard/F.Fab; imported USB graphic differs from the supplied dimensions; installed SD/USB/underside access and height need assembly validation. M02 now tracks these implementation/assembly findings, not access to a drawing. Updated current status, plan and related handoff documents. No Teensy footprint, main schematic/PCB, firmware, commit or push changes in this review.

### Step 3 draft package — Teensy carrier and GPS logical symbol

Created Teensy41_SSW_Carrier as a separate project-local footprint, preserving the 48 imported pad identifiers/coordinates. Selected candidate SSW-124-01-L-S carrier sockets with uniform 1.04 mm drills/1.8 mm pads; added F.Fab geometry, courtyard, a front-side component keepout and drawing-layer USB/SD access allowances. Added generator and native checker. Clear and outside-component fixture controls have zero violations; deliberate intrusion raises items_not_allowed and courtyards_overlap as expected. Native SVG rendered and inspected. Header procurement, tolerances, actual cable/card/enclosure fit and retention remain open; sensor standoff height is not imposed on Teensy.

Added Adafruit_PA1616D_5440_Logical with nine named pin identifiers and an intentionally empty footprint. Native symbol loading and logical pin-type checks pass alongside the existing 15 sensor symbol-to-footprint checks. Initial GPS preview showed duplicate long pin-identifier text crossing the body; hid duplicate numbers while retaining visible names, regenerated and visually checked the corrected preview. Revisited the official #5440 product/guide download links; these still did not establish exact current PA1616D carrier geometry. No physical GPS footprint was invented.

Updated the status, assembly/footprint/mechanical reviews, connection checklist and plan. Three draft footprints and three draft symbols now support subsequent schematic/placement work; GPS exact mechanics and real assembly evidence remain release gates. Main schematic/PCB, imported libraries and firmware remain unchanged. No commit, push, purchase or external message performed.

### Publication requested — Step 3 draft package

Saadat requested committing and pushing the remaining unpublished work to `saadat-dev`. A fresh fetch confirmed the branch matched `origin/saadat-dev` before publication. The publication includes the three draft symbols and Teensy carrier footprint, the 1.04 mm sensor socket drill update, the assembly plan, the Teensy mechanical review and supplied PJRC drawing, generators/checkers and validation evidence. Added a scoped LF attribute for the symbol library. Staged footprint and symbol blobs match their recorded evidence hashes. The main schematic/PCB, imported libraries and firmware are still unchanged. Consult Git history for the commit hash.
