mahruschow/team-pterodactyl/docs/reference/regulator-gps/pololu-pinout.jpg

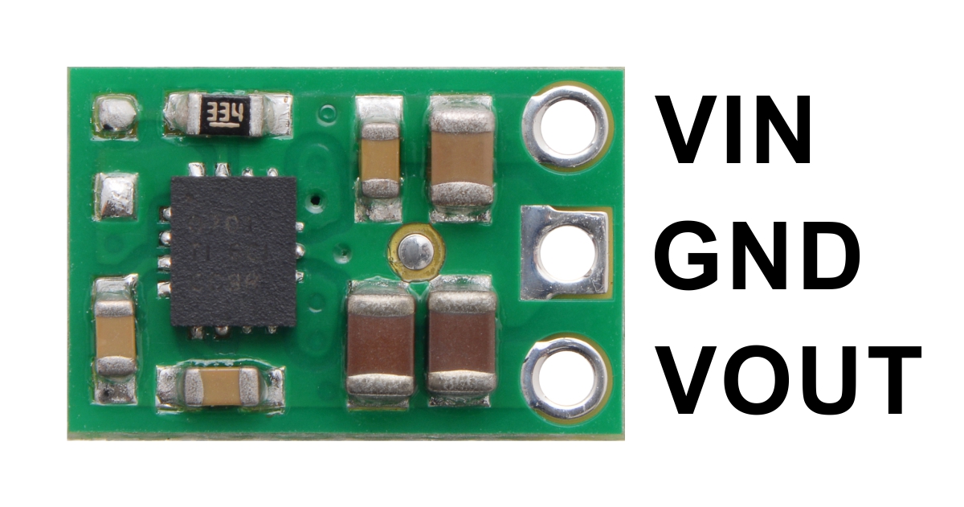
docs/reference/regulator-gps/pololu-pinout.jpg
