mahruschow/team-pterodactyl/mechanical/pcb-holder/Pterodactyl-holder-preview.png

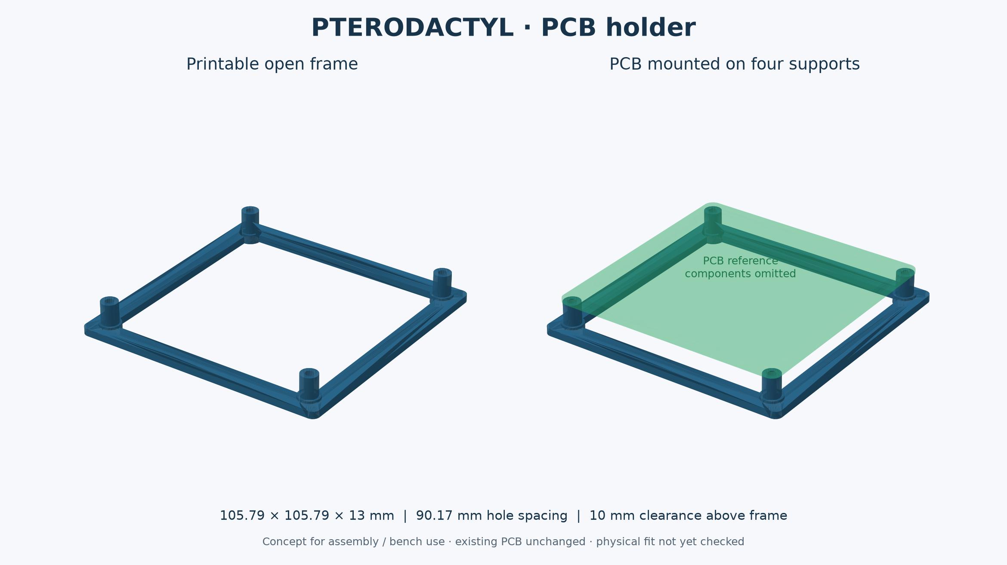
mechanical/pcb-holder/Pterodactyl-holder-preview.png
