mahruschow/team-pterodactyl/docs/validation/2026-10-20/finalization-bom.csv

Refs | Value | Footprint | MPN | Notes | Qty | DNP
C1 | 47u 25V | Capacitor_THT:CP_Radial_D6.3mm_P2.50mm |  |  | 1
C2 | 100n | Capacitor_THT:C_Disc_D5.0mm_W2.5mm_P5.00mm |  |  | 1
C3 | 100u 10V | Capacitor_THT:CP_Radial_D6.3mm_P2.50mm |  | At Teensy VIN | 1
C4 | 100n | Capacitor_THT:C_Disc_D5.0mm_W2.5mm_P5.00mm |  |  | 1
C5 | 10u | Capacitor_THT:C_Disc_D5.0mm_W2.5mm_P5.00mm |  |  | 1
C6 | 10u | Capacitor_THT:C_Disc_D5.0mm_W2.5mm_P5.00mm |  | At U3 BNO055 VIN | 1
C7 | 100n | Capacitor_THT:C_Disc_D5.0mm_W2.5mm_P5.00mm |  | At U3 BNO055 VIN | 1
C8 | 10u | Capacitor_THT:C_Disc_D5.0mm_W2.5mm_P5.00mm |  | At U4 MS8607 VIN | 1
C9 | 100n | Capacitor_THT:C_Disc_D5.0mm_W2.5mm_P5.00mm |  | At U4 MS8607 VIN | 1
C10 | 10u | Capacitor_THT:C_Disc_D5.0mm_W2.5mm_P5.00mm |  | At U5 GPS VIN | 1
C11 | 100n | Capacitor_THT:C_Disc_D5.0mm_W2.5mm_P5.00mm |  | At U5 GPS VIN | 1
D1 | 10V | Diode_THT:D_DO-35_SOD27_P7.62mm_Horizontal | BZX79-C10 (candidate) | Clamps Q1 gate-source voltage | 1
D2 | Red | LED_THT:LED_D5.0mm |  | Vf about 2 V; about 1.9 mA | 1
D3 | Yellow | LED_THT:LED_D5.0mm |  |  | 1
D4 | Green | LED_THT:LED_D5.0mm |  | Use a low-Vf green (about 2.1 V), not a 3 V InGaN part | 1
D5 | Orange | LED_THT:LED_D5.0mm |  |  | 1
F1 | PTC 0.7A hold | Fuse:Fuse_Bourns_MF-RHT070 | Bourns MF-RHT070 (candidate) | Verify voltage rating >= max battery voltage | 1
FB1 | Ferrite | Inductor_THT:L_Axial_L5.0mm_D3.6mm_P10.00mm_Horizontal_Murata_BL01RN1A2A2 | Murata BL01RN1A2A2 (candidate) | Verify current rating > 200 mA | 1
J1 | Battery | Connector_JST:JST_XH_B2B-XH-A_1x02_P2.50mm_Vertical | JST B2B-XH-A (candidate) | Battery connector; final type follows battery choice (D02) | 1
J2 | Power switch | Connector_JST:JST_XH_B2B-XH-A_1x02_P2.50mm_Vertical | JST B2B-XH-A (candidate) | Off-board panel switch rated >= 1 A DC; location follows enclosure (D06) | 1
J3 | Pull-before-flight | Connector_PinHeader_2.54mm:PinHeader_1x02_P2.54mm_Vertical |  | Jumper/pull-pin to GND; role open (D10) | 1
J4 | Spare I/O | Connector_PinHeader_2.54mm:PinHeader_1x08_P2.54mm_Vertical |  | DNP by default; replaces legacy U$1/U$2 expansion. 3.3 V logic only | 1 | DNP
Q1 | IRLML6402 | Package_TO_SOT_SMD:SOT-23 | IRLML6402TRPBF (candidate) | Reverse-polarity protection; verify Vds >= 20 V, Vgs rating vs D1 clamp | 1
R1 | 100k | Resistor_THT:R_Axial_DIN0207_L6.3mm_D2.5mm_P7.62mm_Horizontal |  |  | 1
R2 | 100k 1% | Resistor_THT:R_Axial_DIN0207_L6.3mm_D2.5mm_P7.62mm_Horizontal |  | Battery sense divider top | 1
R3 | 22k 1% | Resistor_THT:R_Axial_DIN0207_L6.3mm_D2.5mm_P7.62mm_Horizontal |  | 16 V in -> 2.89 V at ADC | 1
R4 | 680 | Resistor_THT:R_Axial_DIN0207_L6.3mm_D2.5mm_P7.62mm_Horizontal |  |  | 1
R5 | 680 | Resistor_THT:R_Axial_DIN0207_L6.3mm_D2.5mm_P7.62mm_Horizontal |  |  | 1
R6 | 680 | Resistor_THT:R_Axial_DIN0207_L6.3mm_D2.5mm_P7.62mm_Horizontal |  |  | 1
R7 | 680 | Resistor_THT:R_Axial_DIN0207_L6.3mm_D2.5mm_P7.62mm_Horizontal |  |  | 1
SW1 | Mode | Button_Switch_THT:SW_Slide_SPDT_Straight_CK_OS102011MS2Q | C&K OS102011MS2Q (candidate) | Logic-level input, internal pull-up; role open (D10) | 1
SW2 | User | Button_Switch_THT:SW_PUSH_6mm |  | Internal pull-up; role open (D10) | 1
TP1 | VBAT_PROT | TestPoint:TestPoint_THTPad_D2.0mm_Drill1.0mm |  |  | 1
TP2 | +5V | TestPoint:TestPoint_THTPad_D2.0mm_Drill1.0mm |  |  | 1
TP3 | +3V3 | TestPoint:TestPoint_THTPad_D2.0mm_Drill1.0mm |  |  | 1
TP4 | SENSOR_3V3 | TestPoint:TestPoint_THTPad_D2.0mm_Drill1.0mm |  |  | 1
TP5 | GND | TestPoint:TestPoint_THTPad_D2.0mm_Drill1.0mm |  |  | 1
TP6 | I2C_SDA | TestPoint:TestPoint_THTPad_D2.0mm_Drill1.0mm |  |  | 1
TP7 | I2C_SCL | TestPoint:TestPoint_THTPad_D2.0mm_Drill1.0mm |  |  | 1
TP8 | GPS_TXD | TestPoint:TestPoint_THTPad_D2.0mm_Drill1.0mm |  |  | 1
TP9 | GPS_RXD | TestPoint:TestPoint_THTPad_D2.0mm_Drill1.0mm |  |  | 1
TP10 | VBAT_SENSE | TestPoint:TestPoint_THTPad_D2.0mm_Drill1.0mm |  |  | 1
U1 | Teensy 4.1 | Pterodactyl_Modules:Teensy41_SSW_Carrier | PJRC Teensy 4.1 | Cut VUSB/VIN pads before external power. Remaining pins intentionally unused | 1
U2 | Pololu S9V11F5 | Pterodactyl_Modules:Pololu_S9V11F5_SSW_Carrier | Pololu #2836 | Three-pin carrier; EN not brought to carrier. 3 V minimum at module VIN to start; 2 V running minimum. Socket/retention fit pending | 1
U3 | Adafruit BNO055 #2472 | Pterodactyl_Modules:Adafruit_BNO055_2472_Carrier | Adafruit 2472 | I2C 0x28. PS0/PS1/ADR use onboard pull-downs; INT unused; 3Vo not connected | 1
U4 | Adafruit MS8607 #4716 | Pterodactyl_Modules:Adafruit_MS8607_4716_Carrier | Adafruit 4716 | I2C 0x40/0x76; 3Vo not connected | 1
U5 | Adafruit PA1616D #5440 | Pterodactyl_Modules:Adafruit_GPS_5440_Carrier | Adafruit 5440 | Carrier geometry visually accepted by Saadat 2026-10-20; physical fit/holder clearance pending. EN at onboard default; VBAT/FIX/PPS unused | 1
