mahruschow/team-pterodactyl/docs/validation/2026-10-21/component-finalization/bom.csv

Refs | Value | Footprint | MPN | SelectionStatus | Datasheet | Notes | DNP | Qty
C1 | 100u 25V | Pterodactyl_Modules:Panasonic_EEUFR1E101_P2.50mm | EEUFR1E101 | Prototype selection; hardware verification required | https://industrial.panasonic.com/ww/products/pt/aluminum-cap-lead/models/EEUFR1E101 | 100 uF 25 V; nominal D6.3 H11.2 mm, allow body tolerances. Cold startup/transients untested. |  | 1
C2 | 100n | Pterodactyl_Modules:KEMET_C322_100n_P5.00mm | C322C104K5R5TA | Prototype selection; hardware verification required | https://search.kemet.com/component-documentation/download/specsheet/C322C104K5R5TA | 100 nF 50 V X7R; max body 5.08 x 3.18 x 6.6 mm; 5.00 mm pitch within specified lead tolerance. |  | 1
C3 | 100u 25V | Pterodactyl_Modules:Panasonic_EEUFR1E101_P2.50mm | EEUFR1E101 | Prototype selection; hardware verification required | https://industrial.panasonic.com/ww/products/pt/aluminum-cap-lead/models/EEUFR1E101 | 100 uF 25 V; nominal D6.3 H11.2 mm, allow body tolerances. Cold startup/transients untested. |  | 1
C4 | 100n | Pterodactyl_Modules:KEMET_C322_100n_P5.00mm | C322C104K5R5TA | Prototype selection; hardware verification required | https://search.kemet.com/component-documentation/download/specsheet/C322C104K5R5TA | 100 nF 50 V X7R; max body 5.08 x 3.18 x 6.6 mm; 5.00 mm pitch within specified lead tolerance. |  | 1
C5 | 10u | Pterodactyl_Modules:KEMET_C322_10u_P5.00mm | C322C106K3R5TA | Prototype selection; hardware verification required | https://search.kemet.com/component-documentation/download/specsheet/C322C106K3R5TA | 10 uF 25 V X7R; max body 5.08 x 4.07 x 6.6 mm; verify effective capacitance under bias/cold. |  | 1
C6 | 10u | Pterodactyl_Modules:KEMET_C322_10u_P5.00mm | C322C106K3R5TA | Prototype selection; hardware verification required | https://search.kemet.com/component-documentation/download/specsheet/C322C106K3R5TA | 10 uF 25 V X7R; max body 5.08 x 4.07 x 6.6 mm; verify effective capacitance under bias/cold. |  | 1
C7 | 100n | Pterodactyl_Modules:KEMET_C322_100n_P5.00mm | C322C104K5R5TA | Prototype selection; hardware verification required | https://search.kemet.com/component-documentation/download/specsheet/C322C104K5R5TA | 100 nF 50 V X7R; max body 5.08 x 3.18 x 6.6 mm; 5.00 mm pitch within specified lead tolerance. |  | 1
C8 | 10u | Pterodactyl_Modules:KEMET_C322_10u_P5.00mm | C322C106K3R5TA | Prototype selection; hardware verification required | https://search.kemet.com/component-documentation/download/specsheet/C322C106K3R5TA | 10 uF 25 V X7R; max body 5.08 x 4.07 x 6.6 mm; verify effective capacitance under bias/cold. |  | 1
C9 | 100n | Pterodactyl_Modules:KEMET_C322_100n_P5.00mm | C322C104K5R5TA | Prototype selection; hardware verification required | https://search.kemet.com/component-documentation/download/specsheet/C322C104K5R5TA | 100 nF 50 V X7R; max body 5.08 x 3.18 x 6.6 mm; 5.00 mm pitch within specified lead tolerance. |  | 1
C10 | 10u | Pterodactyl_Modules:KEMET_C322_10u_P5.00mm | C322C106K3R5TA | Prototype selection; hardware verification required | https://search.kemet.com/component-documentation/download/specsheet/C322C106K3R5TA | 10 uF 25 V X7R; max body 5.08 x 4.07 x 6.6 mm; verify effective capacitance under bias/cold. |  | 1
C11 | 100n | Pterodactyl_Modules:KEMET_C322_100n_P5.00mm | C322C104K5R5TA | Prototype selection; hardware verification required | https://search.kemet.com/component-documentation/download/specsheet/C322C104K5R5TA | 100 nF 50 V X7R; max body 5.08 x 3.18 x 6.6 mm; 5.00 mm pitch within specified lead tolerance. |  | 1
D1 | 10V | Diode_THT:D_DO-35_SOD27_P7.62mm_Horizontal | BZX79-C10,133 | Prototype selection; hardware verification required | https://assets.nexperia.com/documents/data-sheet/BZX79.pdf | 10 V nominal zener; low R1 bias does not guarantee a precise 10 V clamp. |  | 1
D2 | Red | LED_THT:LED_D5.0mm | WP7113LID | Prototype selection; hardware verification required | https://www.kingbrightusa.com/images/catalog/SPEC/WP7113LID.pdf | Low-current 5 mm LED, 680 ohm series resistor. Confirm A/K and body/flange clearance on receipt. |  | 1
D3 | Yellow | LED_THT:LED_D5.0mm | WP7113LYD | Prototype selection; hardware verification required | https://www.kingbrightusa.com/images/catalog/SPEC/WP7113LYD.pdf | Low-current 5 mm LED, 680 ohm series resistor. Confirm A/K and body/flange clearance on receipt. |  | 1
D4 | Green | LED_THT:LED_D5.0mm | WP7113LGD | Prototype selection; hardware verification required | https://www.kingbrightusa.com/images/catalog/SPEC/WP7113LGD.pdf | Low-current 5 mm LED, 680 ohm series resistor. Confirm A/K and body/flange clearance on receipt. |  | 1
D5 | Orange | LED_THT:LED_D5.0mm | WP7113LSECK/J4 | Prototype selection; hardware verification required | https://www.kingbrightusa.com/images/catalog/SPEC/WP7113LSECK-J4.pdf | Low-current 5 mm LED, 680 ohm series resistor. Confirm A/K and body/flange clearance on receipt. |  | 1
F1 | PTC 0.7A hold | Fuse:Fuse_Bourns_MF-RHT070 | MF-RHT070-0 | Prototype selection; startup, resistance loss and fault testing open | https://bourns.com/docs/product-datasheets/mf-rht.pdf?sfvrsn=9bedf0c3_50 | 0.7 A hold at 23 C; 0.95 A at -40 C, 0.62 A at +40 C. 0.8 ohm R1max; 97% path efficiency is not guaranteed. |  | 1
FB1 | Ferrite | Inductor_THT:L_Axial_L5.0mm_D3.6mm_P10.00mm_Horizontal_Murata_BL01RN1A2A2 | BL01RN1A2A2B | Candidate rejected; obsolete, replacement required | https://mm.digikey.com/Volume0/opasdata/d220001/medias/docus/2316/BL01RN1A_Spec.pdf | Obsolete BL01RN1 series; do not order for new build. Existing geometry retained pending a validated replacement. |  | 1
J1 | Battery | Pterodactyl_Modules:Molex_0022272021_AISLER | 0022272021 | Prototype selection; hardware verification required | https://www.molex.com/en-us/products/part-detail/22272021 | KK254; -40 to +80 C; 0022012027 housing / 0008500113 contacts. Verify harness polarity, wire insulation and retention. |  | 1
J2 | Power switch | Pterodactyl_Modules:Molex_0022272021_AISLER | 0022272021 | Prototype selection; hardware verification required | https://www.molex.com/en-us/products/part-detail/22272021 | KK254; -40 to +80 C; 0022012027 housing / 0008500113 contacts. Verify harness polarity, wire insulation and retention. |  | 1
J3 | Pull-before-flight | Connector_PinHeader_2.54mm:PinHeader_1x02_P2.54mm_Vertical | HTSW-102-07-T-S | Candidate; shunt and assembled-fit review open | https://suddendocs.samtec.com/catalog_english/tsw_th.pdf | 0.635 mm square posts; verify finished hole and mating shunt. PBF role remains open. |  | 1
J4 | Spare I/O | Connector_PinHeader_2.54mm:PinHeader_1x08_P2.54mm_Vertical | DNP | Do not populate |  | Spare 3.3 V I/O header; no purchased header in default assembly. | DNP | 1
Q1 | AO3401A | Pterodactyl_Modules:AO3401A_SOT23_AISLER | AO3401A | Prototype selection; hardware verification required | https://www.aosmd.com/pdfs/datasheet/AO3401A.pdf | G1 S2 D3; source=VBAT_PROT, drain=VBAT_FUSED. Four L91 cells only; +/-12 V Vgs. No generic 16 V carrier input approval. |  | 1
R1 | 100k | Pterodactyl_Modules:Vishay_MRS16_P7.62mm | MRS16000C1003FCT00 | Prototype selection; hardware verification required | https://www.vishay.com/docs/28724/mrs16m25.pdf | MRS16 1%, 0.4 W, -55 to +155 C; 5 mm minimum formed pitch fits 7.62 mm. MRS25 rejected: minimum pitch 10 mm. Stock/lifecycle recheck before purchase. |  | 1
R2 | 100k 1% | Pterodactyl_Modules:Vishay_MRS16_P7.62mm | MRS16000C1003FCT00 | Prototype selection; hardware verification required | https://www.vishay.com/docs/28724/mrs16m25.pdf | MRS16 1%, 0.4 W, -55 to +155 C; 5 mm minimum formed pitch fits 7.62 mm. MRS25 rejected: minimum pitch 10 mm. Stock/lifecycle recheck before purchase. |  | 1
R3 | 22k 1% | Pterodactyl_Modules:Vishay_MRS16_P7.62mm | MRS16000C2202FCT00 | Prototype selection; hardware verification required | https://www.vishay.com/docs/28724/mrs16m25.pdf | MRS16 1%, 0.4 W, -55 to +155 C; 5 mm minimum formed pitch fits 7.62 mm. MRS25 rejected: minimum pitch 10 mm. Stock/lifecycle recheck before purchase. |  | 1
R4 | 680 | Pterodactyl_Modules:Vishay_MRS16_P7.62mm | MRS16000C6800FCT00 | Prototype selection; hardware verification required | https://www.vishay.com/docs/28724/mrs16m25.pdf | MRS16 1%, 0.4 W, -55 to +155 C; 5 mm minimum formed pitch fits 7.62 mm. MRS25 rejected: minimum pitch 10 mm. Stock/lifecycle recheck before purchase. |  | 1
R5 | 680 | Pterodactyl_Modules:Vishay_MRS16_P7.62mm | MRS16000C6800FCT00 | Prototype selection; hardware verification required | https://www.vishay.com/docs/28724/mrs16m25.pdf | MRS16 1%, 0.4 W, -55 to +155 C; 5 mm minimum formed pitch fits 7.62 mm. MRS25 rejected: minimum pitch 10 mm. Stock/lifecycle recheck before purchase. |  | 1
R6 | 680 | Pterodactyl_Modules:Vishay_MRS16_P7.62mm | MRS16000C6800FCT00 | Prototype selection; hardware verification required | https://www.vishay.com/docs/28724/mrs16m25.pdf | MRS16 1%, 0.4 W, -55 to +155 C; 5 mm minimum formed pitch fits 7.62 mm. MRS25 rejected: minimum pitch 10 mm. Stock/lifecycle recheck before purchase. |  | 1
R7 | 680 | Pterodactyl_Modules:Vishay_MRS16_P7.62mm | MRS16000C6800FCT00 | Prototype selection; hardware verification required | https://www.vishay.com/docs/28724/mrs16m25.pdf | MRS16 1%, 0.4 W, -55 to +155 C; 5 mm minimum formed pitch fits 7.62 mm. MRS25 rejected: minimum pitch 10 mm. Stock/lifecycle recheck before purchase. |  | 1
SW1 | Mode | Button_Switch_THT:SW_Slide_SPDT_Straight_CK_OS102011MS2Q | OS102011MS2QN1 | Candidate; visual drawing and low-level contact reliability review open | https://www.littelfuse.com/assetdocs/littelfuse-c-k-slide-os-series-datasheet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 | SPDT non-shorting, common pin 2. 2025 sheet says -40 to +85 C; older revisions differ. Logic only, not battery power. |  | 1
SW2 | User | Button_Switch_THT:SW_PUSH_6mm | Y97HT21A1FAFP | Candidate; drawing/contact-pair and conflicting height/force table unresolved | https://www.littelfuse.com/assetdocs/littelfuse-c-k-tactile-pts645-series-datasheet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 | PTS645SL50-2 LFS alias; no release on assumed 5 mm/1.3 N. 2026 order table conflicts. Existing 6.5 x 4.5 mm pattern retained pending visual check. |  | 1
TP1 | VBAT_PROT | TestPoint:TestPoint_THTPad_D2.0mm_Drill1.0mm | PCB PAD ONLY | Bare plated test pad; no purchased part |  | Probe existing plated pad; no test-pin hardware populated. |  | 1
TP2 | +5V | TestPoint:TestPoint_THTPad_D2.0mm_Drill1.0mm | PCB PAD ONLY | Bare plated test pad; no purchased part |  | Probe existing plated pad; no test-pin hardware populated. |  | 1
TP3 | +3V3 | TestPoint:TestPoint_THTPad_D2.0mm_Drill1.0mm | PCB PAD ONLY | Bare plated test pad; no purchased part |  | Probe existing plated pad; no test-pin hardware populated. |  | 1
TP4 | SENSOR_3V3 | TestPoint:TestPoint_THTPad_D2.0mm_Drill1.0mm | PCB PAD ONLY | Bare plated test pad; no purchased part |  | Probe existing plated pad; no test-pin hardware populated. |  | 1
TP5 | GND | TestPoint:TestPoint_THTPad_D2.0mm_Drill1.0mm | PCB PAD ONLY | Bare plated test pad; no purchased part |  | Probe existing plated pad; no test-pin hardware populated. |  | 1
TP6 | I2C_SDA | TestPoint:TestPoint_THTPad_D2.0mm_Drill1.0mm | PCB PAD ONLY | Bare plated test pad; no purchased part |  | Probe existing plated pad; no test-pin hardware populated. |  | 1
TP7 | I2C_SCL | TestPoint:TestPoint_THTPad_D2.0mm_Drill1.0mm | PCB PAD ONLY | Bare plated test pad; no purchased part |  | Probe existing plated pad; no test-pin hardware populated. |  | 1
TP8 | GPS_TXD | TestPoint:TestPoint_THTPad_D2.0mm_Drill1.0mm | PCB PAD ONLY | Bare plated test pad; no purchased part |  | Probe existing plated pad; no test-pin hardware populated. |  | 1
TP9 | GPS_RXD | TestPoint:TestPoint_THTPad_D2.0mm_Drill1.0mm | PCB PAD ONLY | Bare plated test pad; no purchased part |  | Probe existing plated pad; no test-pin hardware populated. |  | 1
TP10 | VBAT_SENSE | TestPoint:TestPoint_THTPad_D2.0mm_Drill1.0mm | PCB PAD ONLY | Bare plated test pad; no purchased part |  | Probe existing plated pad; no test-pin hardware populated. |  | 1
U1 | Teensy 4.1 | Pterodactyl_Modules:Teensy41_SSW_Carrier | PJRC Teensy 4.1 |  |  | Cut VUSB/VIN pads before external power. Remaining pins intentionally unused |  | 1
U2 | Pololu S9V11F5 | Pterodactyl_Modules:Pololu_S9V11F5_SSW_Carrier | Pololu #2836 |  | https://www.pololu.com/product/2836 | Three-pin carrier; EN not brought to carrier. 3 V minimum at module VIN to start; 2 V running minimum. Socket/retention fit pending |  | 1
U3 | Adafruit BNO055 #2472 | Pterodactyl_Modules:Adafruit_BNO055_2472_Carrier | Adafruit 2472 |  | https://www.adafruit.com/product/2472 | I2C 0x28. PS0/PS1/ADR use onboard pull-downs; INT unused; 3Vo not connected |  | 1
U4 | Adafruit MS8607 #4716 | Pterodactyl_Modules:Adafruit_MS8607_4716_Carrier | Adafruit 4716 |  | https://www.adafruit.com/product/4716 | I2C 0x40/0x76; 3Vo not connected |  | 1
U5 | Adafruit PA1616D #5440 | Pterodactyl_Modules:Adafruit_GPS_5440_Carrier | Adafruit 5440 |  | https://www.adafruit.com/product/5440 | Carrier geometry visually accepted by Saadat 2026-10-20; physical fit/holder clearance pending. EN at onboard default; VBAT/FIX/PPS unused |  | 1
