mahruschow/team-pterodactyl/docs/reference/Budgets_2026-10-18.xlsx

Item | Use | Cost (USD) | Weight (g) | Voltage (V) | Current (mA) | mWatt | Watt | Watt hours | Link
Board | Mounting + wiring | $30.00 | 12.0 | n.a. | 0.0 | 0.0 | 0.0000 | 0.0000 | Adafruit (https://www.adafruit.com/product/1609)
Teensy 4.1 | Sensor control + SD logging | $31.50 | 5.0* | 5.0 | 100.0* | 500.0 | 0.5000 | 1.5000 | SparkFun (https://www.sparkfun.com/teensy-4-1.html)
BNO-055 | Orientation + motion | $34.95 | 3.0 | 3.3 | 15.0* | 49.5 | 0.0495 | 0.1485 | Adafruit (https://www.adafruit.com/product/2472)
MS-8607 | Pressure, humidity + temp | $14.95 | 2.0* | 3.3 | 5.0* | 16.5 | 0.0165 | 0.0495 | Adafruit (https://www.adafruit.com/product/4716)
GLONASS + GPS - PA1616D | Position, altitude + time | $29.95 | 9.0 | 3.3 | 34.0 | 112.2 | 0.1122 | 0.3366 | Adafruit (https://www.adafruit.com/product/5440)
Total |  | $141.35 | 31.0 |  |  |  |  | 2.0346
Duration (h) | 3
Assumptions | Board = half-size Perma-Proto. * = estimate.
Power basis | 5 V Teensy. 3.3 V sensors. Excludes SD draw/regulator losses.
Cost basis | One each. Excludes tax/shipping. Prices checked Oct 7, 2026.
