mahruschow/team-pterodactyl/docs/releases/2026-10-21-P1/Pterodactyl-budget-2026-10-21.xlsx

Sheet: Budget summary
PTERODACTYL budget review
October 21, 2026 | First prototype order preparation
Metric | Value | Unit | Meaning
5 V average load | 1.23 | W | Includes added 3.3 V linear-regulator loss
Battery average input | 1.62 | W | 85% conversion + provisional 90% path efficiency; see resistance screening
Battery peak screening input | 3.57 | W | Assumed simultaneous loads; measure startup/write peaks
Known-cost subtotal | $129.37 | USD | Excludes all currently unpriced items
Complete procurement budget | Incomplete | USD | Supplier quotes, tools, shipping and taxes remain incomplete
Mass subtotal with inputs | 170.2 | g | Includes allowances; see missing mass lines
Complete installed mass | Incomplete | g | Complete only when all mass inputs are supplied
Required runtime energy target | 8.67 | Wh | 3 h confirmed; includes proposed reserve and usable-energy allowances
Total powered runtime (h) | Battery energy used (Wh) | Nameplate energy target (Wh)
2.0 | 3.24 | 5.78 | 3 h is the confirmed runtime; other durations are comparisons.
3.0 | 4.85 | 8.67 | Nameplate target includes 25% reserve and 70% usable energy.
4.0 | 6.47 | 11.56 | Temperature/cutoff derating must be replaced with pack-specific evidence.
6.0 | 9.71 | 17.34
Team review / follow-up | Review status as of 2026-10-21
Runtime / minimum battery temperature | 3 h / -40 °C confirmed
Battery pack and cutoff | 4 L91 + BH4AAW selected for first build
SD model / measured current | SDCIT2/8GB selected; current unmeasured
0.7 A PTC and power path | Retained for P1; low-voltage limits documented
Package dimensions | Casing deferred beyond first prototype
Quoted cost / measured mass | Incomplete
Release readiness | PCB checks pass; AISLER checkout ready
Next: sign in to AISLER, confirm delivered quote, order PCB and parts, then assemble the first prototype.
Physical testing, flight qualification and later revisions are outside the current project scope.

Sheet: Power
PTERODACTYL power budget
Planning allowances, not measured limits. 600 MHz, continuous logging; no telemetry or heater.
Load / reference | Qty | Rail V | Avg mA/unit | Peak mA/unit | Avg load W | 5 V avg mA | 5 V peak mA | Supply group | Basis / action | Source, checked 2026-10-20
Teensy 4.1 base / U1 | 1 | 5.0 | 150.00 | 250.00 | 0.750 | 150.0 | 250.0 | Controller | 150/250 mA allowances excluding card/sensors. PJRC text cites 4.0, not a 4.1 maximum. Measure firmware load. | https://www.pjrc.com/store/teensy41.html
microSD card / U1 socket | 1 | 3.3 | 30.00 | 200.00 | 0.099 | 30.0 | 200.0 | Onboard SD | Kingston SDCIT2/8GB selected for prototype; 30/200 mA remain allowances, not published limits. | https://www.kingston.com/datasheets/SDCIT2_en.pdf
BNO055 #2472 / U3 | 1 | 3.3 | 20.00 | 25.00 | 0.066 | 20.0 | 25.0 | External | 20/25 mA breakout allowances. Bosch lists 12.3 mA for chip 9DOF; allowance includes board overhead. | https://www.bosch-sensortec.com/media/boschsensortec/downloads/promotion_material/product-selector-en.pdf
GPS #5440 / U5 | 1 | 3.3 | 35.00 | 50.00 | 0.116 | 35.0 | 50.0 | External | 35/50 mA allowances. Published navigation/acquisition: 29/34 mA. Internal antenna only. | https://www.adafruit.com/product/5440
MS8607 #4716 / U4 | 1 | 3.3 | 2.00 | 5.00 | 0.007 | 2.0 | 5.0 | External | 2/5 mA breakout allowances; do not equate sensor low-power figure with whole-board current. | https://www.adafruit.com/product/4716
Status LEDs / D2–D5 | 4 | 3.3 | 2.19 | 3.00 | 0.029 | 8.7 | 12.0 | External | All four on: typical Vf red 1.70, yellow 1.85, green 1.90, orange 1.80 V at 2 mA. Peak 3 mA/LED is an allowance. | Kingbright WP7113LID, WP7113LYD, WP7113LGD, WP7113LSECK/J4 datasheets; tools/component_selections.py
I2C + control pull-ups | 1 | 3.3 | 1.00 | 3.00 | 0.003 | 1.0 | 3.0 | External | 1/3 mA combined allowance; verify parallel breakout pull-ups and asserted input loads. | Current v4 schematic; engineering assumption
Total load / current |  |  |  |  | 1.069 | 246.8 | 545.0
 |  |  | Average | Peak allowance
5 V regulator output power (W) |  |  | 1.234 | 2.725 |  |  |  |  | 3.3 V loads draw approximately the same current through the Teensy linear regulator.
Added 5 → 3.3 V LDO heat (W) |  |  | 0.164 | 0.502 |  |  |  |  | This heat is already included in 5 V input power. Do not add it twice.
External 3.3 V current (mA) |  |  | 66.8 | 95.0
External 3.3 V guidance (mA) |  |  | 250.0 |  |  |  |  |  | PJRC external-pin recommendation; onboard SD still contributes to regulator heating. | https://www.pjrc.com/store/teensy41.html
External current headroom (mA) |  |  | 183.2 | 155.0
3.3 V added load including SD (mA) |  |  | 96.8 | 295.0
Editable assumptions | Value | Unit
Buck-boost efficiency | 85% | % |  |  |  |  |  |  | 85% planning value, not a guaranteed efficiency floor. Confirm at chosen battery voltage/load. | https://www.pololu.com/product/2836
Protection / wiring efficiency | 90% | % |  |  |  |  |  |  | 90% provisional path efficiency replaces optimistic 97%; neither is a cold guarantee. See resistance screening below. | MF-RHT070-0 R1max 0.8 ohm after trip at 23 C; AO3401A 85 milliohm max at Vgs=-2.5 V, 25 C
Usable battery-energy fraction | 70% | % |  |  |  |  |  |  | 70% usable-energy placeholder for cold/cutoff/aging. Not battery-specific qualification. | Engineering assumption; usable capacity at -40 °C is not yet verified
Energy reserve | 25% | % |  |  |  |  |  |  | 25% additional energy reserve; proposed, not team-approved. | Engineering assumption
Battery-side auxiliary allowance | 0.005 | W |  |  |  |  |  |  | 5 mW for divider/gate bias/leakage; converter quiescent loss is included in efficiency. | Current v4 R1=100k, R2+R3=122k; engineering allowance
Mean LED Vf at 2 mA (typical) | 1.81 | V |  |  |  |  |  |  | Mean of selected LED typical Vf values; no guaranteed current bound at cold or resistor/rail tolerances. | Current v4 schematic notes
LED series resistance | 680.00 | ohm |  |  |  |  |  |  | Current fitted resistor value. | Current v4 schematic R4–R7
Required total powered runtime | 3.00 | h |  |  |  |  |  |  | Three-hour required total powered runtime; budget includes separate energy reserve. | Saadat confirmation in chat, 2026-10-20
Selected battery nominal voltage | 6.00 | V |  |  |  |  |  |  | Four series primary lithium AA cells, 1.5 V nominal each. No charging. | https://data.energizer.com/pdfs/L91GL0225.pdf
Minimum battery terminal voltage |  | V |  |  |  |  |  |  | Must include discharge behavior and temperature; converter VIN must exceed 3 V at startup after drops. | https://www.pololu.com/product/2836
Selected battery / protection | 4 x L91 series / BH4AAW | part number |  |  |  |  |  |  | BH4AAW and four L91 cells selected for first build. Add insulated 025101.5MXL pack fuse; see assembly instructions. Runtime remains unmeasured. | https://www.batteryholders.com/uploads/parts/BH4AAW/datasheets/BH4AAW-datasheet.pdf
Minimum battery operating temperature | -40 | °C |  |  |  |  |  |  | Lead requirement replaces earlier -45 °C estimate; cold capability still needs verification. | Lead reply supplied by Saadat, 2026-10-20
 |  |  | Average | Peak allowance
Battery input power (W) |  |  | 1.618 | 3.568 |  |  |  |  | Peak is a simultaneous-load screening allowance, not a measured maximum or inrush waveform.
Nameplate energy per runtime hour (Wh/h) |  |  | 2.890 |  |  |  |  |  | Battery input W × (1 + reserve) ÷ usable energy fraction. Runtime is separate.
Required nameplate energy (Wh) |  |  | 8.669
Required nominal pack capacity (Ah) |  |  | 1.445
Peak battery current at minimum V (A) |  |  | Set minimum voltage
Current candidate PTC hold rating (A) |  |  | 0.700 |  |  |  |  |  | MF-RHT070-0 hold: 0.95 A at -40 C, 0.70 A at 23 C, 0.62 A at 40 C. Hold is not instantaneous trip current.
PTC review |  |  | Choose battery first
Example terminal V | Average battery A | Peak battery A | Existing PTC screening
3 | 0.539 | 1.189 | Review peak / trip curve
3.7 | 0.437 | 0.964 | Review peak / trip curve
5 | 0.324 | 0.714 | Review peak / trip curve
7.4 | 0.219 | 0.482 | Check derating / trip curve
Voltage examples are not selected batteries. 3 V at the pack leaves no startup margin after losses.
Requirements: 3 h and -40 °C battery minimum. Actual current, cold capacity and thermal behavior remain unverified.
Power-path resistance screening — illustrative terminal voltages, not discharge qualification
Total series resistance allowance | 1.15 | ohm |  |  |  |  |  |  | 1.15 ohm screen: 0.8 PTC + 0.085 Q1 + 0.10 pack fuse allowance + 0.165 wiring/switch/contact allowance. Not a guaranteed cold maximum. | Bourns MF-RHT070; AO3401A; Littelfuse 251/253 sheet (025101.5MXL nominal 0.0823 ohm); docs/FIRST_PROTOTYPE_RELEASE.md
Pack terminal V | Avg module W | Peak module W | Avg battery A | Peak battery A | Peak path loss W | Peak module VIN | Startup screening
6 | 1.456 | 3.211 | 0.255 | 0.605 | 0.421 | 5.304 | Above 3 V threshold
4.8 | 1.456 | 3.211 | 0.329 | 0.837 | 0.805 | 3.838 | Above 3 V threshold
4 | 1.456 | 3.211 | 0.413 | 1.257 | 1.817 | 2.555 | Below 3 V startup
Constant-power calculation: Vpack I = Pmodule + I²R. Cell internal loss is excluded; voltage is at pack terminals.
A 3 V startup threshold is necessary, not sufficient. Test cold startup, SD peaks, PTC heating and end-of-discharge recovery.

Sheet: Cost and mass
PTERODACTYL cost and mass
One assembled prototype; USD. Blank inputs remain missing. Nothing ordered. Prices checked 2026-10-20.
Item / scope | Qty | Unit cost $ | Line cost $ | Unit mass g | Line mass g | Cost basis | Mass basis | References | Source / basis | Notes
Teensy 4.1 DEV-16771 | 1 | $31.50 | $31.50 | 7.0 | 7.0 | Listed price | Allowance | U1 | https://www.sparkfun.com/teensy-4-1.html | Mass allowance only; no card or headers.
Adafruit BNO055 #2472 | 1 | $34.95 | $34.95 | 3.0 | 3.0 | Listed price | Published | U3 | https://www.adafruit.com/product/2472 | Published board mass; confirm assembled header basis.
Adafruit MS8607 #4716 | 1 | $14.95 | $14.95 | 2.0 | 2.0 | Listed price | Allowance | U4 | https://www.adafruit.com/product/4716 | Whole breakout mass allowance, not sensor-package mass.
Adafruit GPS #5440 | 1 | $29.95 | $29.95 | 9.0 | 9.0 | Listed price | Published | U5 | https://www.adafruit.com/product/5440 | Published product mass; no optional coin cell or external antenna.
Pololu S9V11F5 #2836 | 1 | $6.95 | $6.95 | 0.5 | 0.5 | Listed price | Published | U2 | https://www.pololu.com/product/2836 | 0.5 g without pins per /specs; quote may require backorder.
Carrier PCB, one installed | 1 |  | Missing | 35.0 | 35.0 | Quote needed | Allowance | PCB | Current approximately 98 × 98 mm, 4-layer layout | AISLER TCVOYNZG rev1 processed: 97.79 x 97.79 mm, 4 layers, 1.6 mm, 35 um ENIG. 3 bare boards EUR 51.37 net provisional; not converted into this USD model.
Module interconnect rows; mixed mounting | 7 |  | Missing |  | Missing | Quote needed | Missing | 75 positions | Saadat assembly update, 2026-10-20; docs/MODULE_ASSEMBLY_PLAN.md | BNO055/MS8607/GPS: HTSW -15 pins soldered at both boards, 12 mm nominal spacing. Teensy/regulator: SSW -01 / HTSW -07. Mass remains unmeasured.
Passive/protection component lot | 1 |  | Missing | 8.0 | 8.0 | Quote needed | Allowance | R1–R7, C1–C11, D1, FB1, F1, Q1 | Current v4 schematic; 22 components | All PCB MPNs selected for first prototype; FB1 Laird 28L0138-10R-10 replaces obsolete Murata. 8 g lot allowance includes 0.875 g MRS16 resistors.
Low-Vf indicator LEDs | 4 |  | Missing | 0.3 | 1.2 | Quote needed | Allowance | D2–D5 | Current v4 schematic | Selected low-current Kingbright MPNs in KiCad BOM; mass allowance remains unmeasured.
Populated carrier connectors | 3 |  | Missing | 1.0 | 3.0 | Quote needed | Allowance | J1–J3; J4 DNP | Current v4 schematic | J1/J2 0022272021; J3 HTSW-102-07-T-S with SNT-100-BK-T shunt. 1 g/unit is an allowance; harness plugs counted separately.
Onboard controls | 2 |  | Missing | 1.0 | 2.0 | MPNs needed | Allowance | SW1–SW2 | Current v4 schematic | SW1 OS102011MS2QN1; SW2 PTS645SL50-2 LFS. Drawings/pin patterns checked for first prototype.
Bare plated test pads | 10 | $0.00 | $0.00 | 0.0 | 0.0 | No purchased part | PCB included | TP1–TP10 | Current v4 schematic | No test-pin hardware. Pad copper is included in PCB mass.
Kingston SDCIT2/8GB | 1 |  | Missing | 0.5 | 0.5 | Quote needed | Allowance | U1 socket | https://www.kingston.com/datasheets/SDCIT2_en.pdf | Industrial microSD -40 to +85 C. 0.5 g allowance; exact write/inrush maximum and cold endurance unverified.
External power switch | 1 | $11.07 | $11.07 | 4.0 | 4.0 | Supplier snapshot | Allowance | C&K 7101SYZQE | https://www.digikey.com/en/products/detail/c-k/7101SYZQE/25966 | USD 11.07 single-unit snapshot, 2026-10-21; tax/shipping excluded. -30 to +85 C, first room-temperature prototype. 4 g remains an allowance.
Wiring / mating plugs lot | 1 |  | Missing | 10.0 | 10.0 | Quote needed | Allowance | Harness | Assembly plan pending | 10 g allowance for added wire, plugs, crimps, 025101.5MXL pack fuse, insulation and strain relief. Holder leads counted in BH4AAW. Tool cost not included.
Retention / spacers / screws lot | 1 |  | Missing | 10.0 | 10.0 | Select hardware | Allowance | Modules and H1–H4 | docs/MODULE_ASSEMBLY_PLAN.md | All carrier and module mounting hardware; verify magnetism and installed fit.
4 L91 cells + BH4AAW holder | 1 |  | Missing | 75.0 | 75.0 | Quote needed | Published + estimate | Battery | Energizer L91: 15 g/cell; MPD BH4AAW: estimated 15.05 g, manufacturer drawings. | 60 g cells + 15.05 g wired holder. Excludes plug, added harness and retention (other rows). Complete pack not yet qualified.
Enclosure | 1 |  | Missing |  | Missing | Design/quote | Missing | Enclosure | Lead: as small as possible while functional | Define dimensions after battery, connector and retention decisions.
Insulation / vent / payload mounting | 1 |  | Missing |  | Missing | Define scope | Missing | Integration | Operating environment and payload mounting pending | Enter zero only if explicitly unnecessary; not currently zero.
Shipping / minimum-order extras | 1 |  | Missing | 0.0 | 0.0 | Quote needed | Not flown | Procurement | Supplier carts not created | Include fabrication lot minimum and extra purchased units here; exclude from flight mass.
Taxes / duties | 1 |  | Missing | 0.0 | 0.0 | Quote needed | Not flown | Procurement | Destination and final order pending | Actual payable taxes, not assumed zero.
Prototype spares / rework | 1 |  | Missing | 0.0 | 0.0 | Agree allowance | Not flown | Procurement | Team purchasing decision pending | Extra procurement allowance; not installed flight mass.
Known-cost subtotal only ($) |  |  | $129.37 |  |  |  |  |  | Subtotal excludes unpriced items; full procurement cost is shown separately.
Full prototype procurement ($) |  |  | Incomplete
Missing cost lines |  |  | 15
Mass subtotal with inputs (g) |  |  |  |  | 170.2 |  |  |  | Subtotal includes allowances; missing mass lines are counted below.
Complete installed mass (g) |  |  |  |  | Incomplete
Missing mass lines |  |  |  |  | 3
Published module mass subset (g) |  |  |  |  | 12.5
Amber cells are editable inputs. Published masses, engineering allowances and missing values are distinguished.
Confirm price, stock, exact MPNs, batch minimums and included headers before ordering. No order placed.
Reference budget from the lead is a different payload. Its pumps/heaters, two-hour duration and 37 Wh pack are excluded.
