mahruschow/team-pterodactyl/docs/reference/regulator-gps/reg20a-drill.dxf

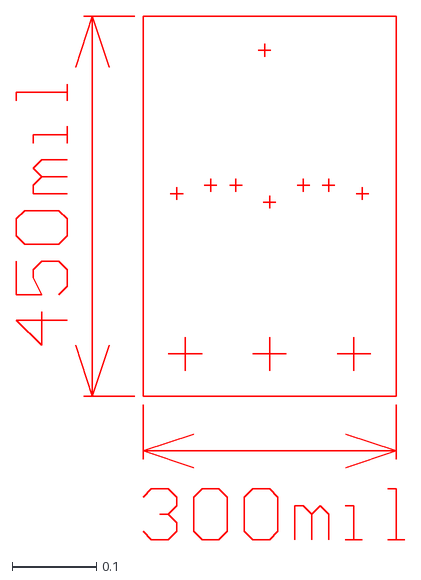
[picture p4: CAD file, 2026-10-19]
docs/reference/regulator-gps/reg20a-drill.dxf
0.46 x 0.62
