mahruschow/team-pterodactyl/mechanical/pcb-holder/Holder-with-reference-PCB.step

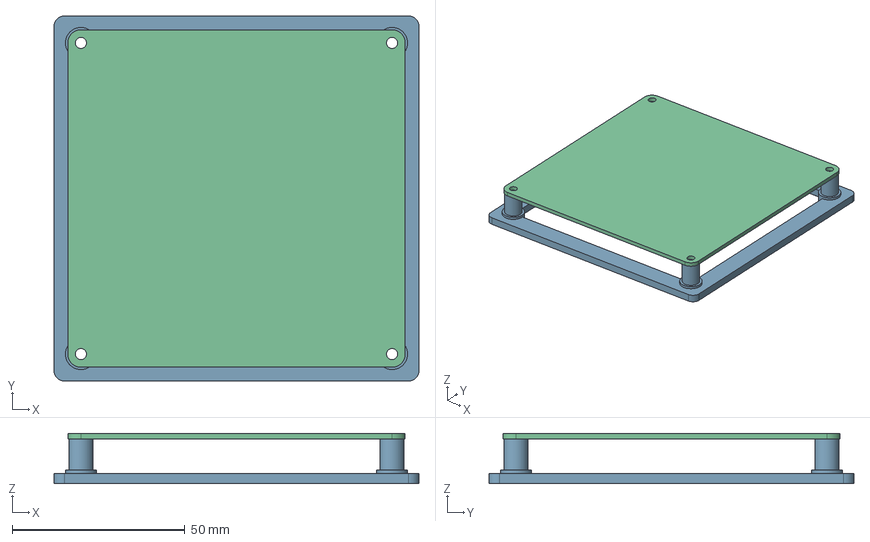
[picture p5: CAD file, 2026-10-21]
mechanical/pcb-holder/Holder-with-reference-PCB.step
105.8 x 105.8 x 14.6 mm
PRINT_THIS_holder
REFERENCE_ONLY_unpopulated_PCB
