mahruschow/team-pterodactyl/mechanical/pcb-holder/Pterodactyl-holder.step

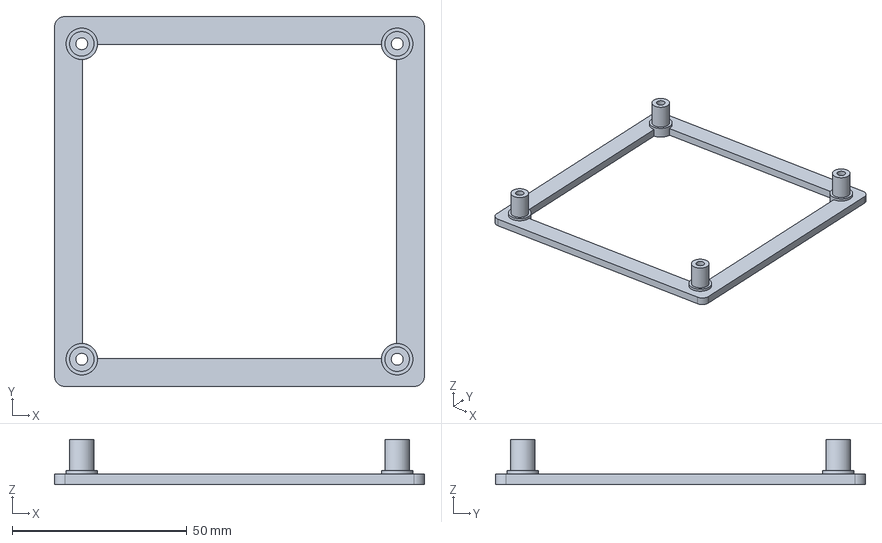
[picture p6: CAD file, 2026-10-21]
mechanical/pcb-holder/Pterodactyl-holder.step
105.8 x 105.8 x 13.0 mm
