mahruschow/team-pterodactyl/(list of files, cad)

Other CAD files:
Original_Fusion_source/PTERODACTYL_v3.8_v11.f3z
mechanical/pcb-holder/Pterodactyl-holder.stl
