mahruschow/team-pterodactyl/docs/MODULE_ASSEMBLY_PLAN.md

# Step 3 — module assembly proposal and closure gates

## Team-name silkscreen update — October 21, 2026

Saadat Muyeen, Mahrus Chowdhury and Ryeed Zaman are now on the back silkscreen, with 2 mm text and 0.30 mm strokes. Fresh DRC, connectivity and schematic-parity checks report zero issues. All original PCB bytes are retained; only three text objects were added. The other eight Gerber layers match the prior geometry exactly, apart from export timestamps. Existing ERC evidence remains applicable to the unchanged schematic.

**Order the updated native PCB or fabrication ZIP. AISLER TCVOYNZG revision 1 is superseded and does not contain the names.** Two revision-upload attempts failed; the alternate upload form says an anonymous project is already in progress and requires login to save it. Sign in and upload the updated board, then inspect the bottom preview before ordering. No new AISLER revision or order has been created. Earlier statements below about revision 1 being the exact current PCB or ready for checkout refer to the previous checkpoint.

## First prototype scope and order checkpoint - October 21, 2026

**Current authority: [FIRST_PROTOTYPE_RELEASE.md](FIRST_PROTOTYPE_RELEASE.md).** PCB checks and AISLER upload/preview passed; project TCVOYNZG revision 1 is ready for checkout. FB1/SW1/SW2/J3 are selected for P1. The user explicitly excludes physical testing, flight qualification, subsequent redesign and casing from this phase; older statements requiring those before PCB fabrication are superseded. Assembly receipt/polarity checks remain part of building the prototype. No order placed. Updated known cost is USD 129.37 (15 price lines missing); entered mass 170.25 g (three missing). The provisional EUR board quote is separate.

**Current implementation — October 21:** Targeted component/connector/capacitor edits and the budget update are now applied. Fresh ERC/DRC/connectivity/parity and preservation checks pass. Read [RESUME_HERE.md](RESUME_HERE.md), then [COMPONENT_IMPLEMENTATION.md](COMPONENT_IMPLEMENTATION.md) for the authoritative boundary. Four BOM references remain explicit candidates; holder/harness fit, cold runtime and flight qualification remain open. Earlier dated figures and research-only statements below are historical where superseded.

## Current component and pack fit review

J1/J2 are now Molex 0022272021 with proposed 0022012027 housings / 0008500113 crimps. J2 is a switch loop, not a power-and-ground output. Sensor soldered-header candidates are Samtec HTSW-106-15-T-S, HTSW-104-15-T-S, HTSW-105-15-T-S and HTSW-109-15-T-S. Their 0.635 mm square pins and nominal -15 lengths have been screened; actual finished-hole tolerance, module thickness, spacer height and solder protrusion still require dry-fit. No sensor sockets are reinstated.

BH4AAW is the rated prototype holder candidate: 61.72 x 57.15 x 15.88 mm body, approximately 15.05 g, plus four L91 cells at 60 g. Harness exit, strain relief, secure cell restraint, nonmagnetic hardware and actual loaded envelope remain open. Panasonic capacitors are nominally 11.2 mm high; remove any older 7 mm height assumption. KEMET capacitor local footprints now use maximum body envelopes. The board outline and module positions remain unchanged; four small capacitor/test-pad moves are recorded in COMPONENT_IMPLEMENTATION.md.

Older mounting alternatives below are historical where they conflict with the soldered-sensor requirement and current component review.

## Current assembly direction — October 20

Saadat confirms the sensors will use **through-hole soldering**. Working implementation: BNO055 #2472, MS8607 #4716 and GPS #5440 breakout boards connected through header pins soldered at both the breakout and carrier plated-through holes, without removable sensor sockets. This retains the selected breakout modules; it does not replace them with bare sensor ICs. Teensy/regulator mounting was not changed by this instruction.

The earlier SSW sensor sockets and 12 mm socket-derived spacing below are historical proposals, superseded for the sensor modules. Select exact solderable header lengths and verify pin cross-section versus finished drill tolerance, sufficient solder-tail protrusion at both boards, insulator position, underside component/holder clearance, and a supported assembly sequence. Do not assume removing the sockets permits the modules to sit flush. Keep separate mechanical retention where required; solder joints alone are not a verified flight-load restraint. Existing PCB holes have not yet been requalified for the new header selection, and no footprint or routing was changed in this update.

Saadat plans to CAD a custom casing after the PCB layout is complete. Reserve the mounting, battery, cable and access envelope now; perform casing CAD against final board/module heights and verify the fit before fabrication release. Include GPS antenna exposure, pressure venting and USB/microSD access. The battery minimum operating-temperature requirement is **-40 C**, supplied by the lead via Saadat; verify the selected interconnect/material ratings for their actual operating environment.

**October 20 GPS update:** [U5 is now assigned, placed and routed](GPS_CARRIER_INTEGRATION.md) after Saadat visually accepted the source CAD geometry. Earlier requests to obtain geometry before assignment are superseded. Actual-module fit, socket/spacer choice, underside holder clearance, antenna exposure and retention still need evidence; this is not manufacturer confirmation or fabrication approval.

October 18, 2026. This is a reviewable prototype proposal, not an order list or a flight-qualified assembly. Exact spreadsheet products remain unchanged. Main schematic and PCB integration belongs to Step 5.

## Historical socket proposal — superseded for sensors

Use female sockets on the carrier and downward-facing male headers on the BNO055/MS8607 modules. Populate both BNO055 rows, including electrically unused pins. Keep the modules removable for bench troubleshooting, with separate mechanical retention.

| Location | Carrier socket, quantity 1 | Module header, quantity 1 |
| --- | --- | --- |
| BNO055 JP1, 6 positions | Samtec SSW-106-01-L-S | Samtec HTSW-106-07-L-S |
| BNO055 JP2, 4 positions | Samtec SSW-104-01-L-S | Samtec HTSW-104-07-L-S |
| MS8607 JP2, 5 positions | Samtec SSW-105-01-L-S | Samtec HTSW-105-07-L-S |

These are configured series part-number proposals; stock, cost and exact orderable configuration have not been confirmed. Do not substitute the supplied generic headers without checking dimensions. The selected families use 2.54 mm pitch and 0.635 mm square mating posts; HTSW is the high-temperature header option. The -07 header has a 5.84 mm mating post, 2.54 mm solder tail and 10.92 mm total length. Its inferred insulator thickness is 2.54 mm. [Samtec TSW/HTSW catalog](https://suddendocs.samtec.com/catalog_english/tsw_th.pdf).

SSW -01 sockets have a nominal 8.51 mm body height, 2.64 mm solder tail, and 3.68–6.35 mm insertion range. Single-row body width is 2.41 mm, with length 2.54 × positions + 0.51 mm. The single-row recommended PCB pattern specifies 1.04 mm holes. Both draft carrier footprints now use that drill with 1.8 mm pads; nominal radial annulus is 0.38 mm. Confirm finished-hole tolerance and annular-ring requirements with the fabricator. [SSW catalog](https://suddendocs.samtec.com/catalog_english/ssw_th.pdf), [SSW single-row footprint, revision A](https://suddendocs.samtec.com/prints/ssw-s.pdf).

Teensy now has a separately reviewed two-row SSW-124 socket carrier and a candidate HTSW header arrangement; see TEENSY_MECHANICAL_REVIEW.md. Its fully seated spacing is nominally 11.05 mm. The sensor 12 mm standoff scheme does not apply to Teensy. GPS retains its exact-geometry gate.

## Historical socket height calculation — recalculate for through-hole assembly

For the two sensor modules, target **12 mm from carrier top surface to module underside** using four insulating spacers per module. Start the fit review with M2 through-fasteners, spacer outside diameter at most 4 mm, and head/washer outside diameter at most 6 mm. Carrier holes remain 2.7 mm NPTH; module holes in the source CAD are 2.5 mm. This is a size envelope, not a qualified fastener part number. Final polymer, thread engagement, torque, creep, temperature and vibration retention need team review; do not assume generic nylon hardware is flight-qualified. Avoid assuming stainless hardware is nonmagnetic.

Nominal connector calculation: fully seated spacing is 8.51 + 2.54 = 11.05 mm. At 12 mm spacing, the body gap is 0.95 mm and post engagement is 5.84 − 0.95 = **4.89 mm**, inside the stated insertion range. This calculation excludes manufacturing tolerances and board bow. A fully seated connector cannot be forced into a shorter spacer stack. Check worst-case engagement and fit before fixing a spacer part number.

No carrier components underneath either module in the initial layout. Count actual underside parts and solder protrusions; 12 mm spacing is not a measured clearance result. Keep sockets level during soldering, check module orientation against pad 1/VIN, and support the board without bending it when tightening hardware. Do not connect a carrier rail to the breakout's 3Vo output.

## Symbols ready for schematic integration

The `Pterodactyl_Modules` symbol library now contains `Adafruit_BNO055_2472` and `Adafruit_MS8607_4716`, with the matching carrier footprint field populated. VIN/GND are power inputs, 3Vo is a power output, SDA/SCL are bidirectional (including clock stretching), controls are inputs, and INT is an output. No pins are hidden or pre-marked no-connect. Apply the reviewed unused-pin dispositions explicitly in Step 5.

Native KiCad SVG export passed. An independent checker verified all 15 pin functions/types, CSV mappings, assigned footprint names and native-loaded pad numbers. [Symbol evidence](validation/2026-10-18/step3-symbols/symbol-contract-check.json). This is a library contract check, not ERC of a wired circuit. Reproduce with KiCad Python: `tools/verify_module_symbols.py`; pass the CLI path as its first argument if needed.

### GPS logical symbol

`Pterodactyl_Modules:Adafruit_PA1616D_5440_Logical` represents nine reviewed interface functions. Pin identifiers are signal names (VIN, GND, TX, RX, 3V3_OUT, EN, VBAT, FIX, PPS), not asserted physical positions. The duplicated pin-number text is hidden; names remain visible. `3V3_OUT` denotes the breakout pin printed 3.3V. It is a regulator output, separate from VIN; TX/FIX/PPS are outputs, RX/EN inputs, and VBAT a power input. The footprint field is intentionally blank. Native SVG load and all nine logical names/types pass. A future physical footprint must map to these names explicitly or use a reviewed symbol revision. [Adafruit pin functions](https://learn.adafruit.com/adafruit-ultimate-gps/pinouts), [selected product](https://www.adafruit.com/product/5440).

## October 19 regulator/GPS update

The source-checked regulator carrier and an explicitly unverified legacy GPS comparison footprint are documented in [REGULATOR_GPS_FOOTPRINTS.md](REGULATOR_GPS_FOOTPRINTS.md). U2 is integrated in v4; GPS remains unassigned. M01, M03 and M04 are not closed by these digital checks.

## Remaining closure record

| ID | Evidence needed | Who/action | Gate |
| --- | --- | --- | --- |
| M01 | Exact #5440 revision, header order/coordinates, holes, antenna and underside holder dimensions | Lead/team obtain manufacturer drawing or actual board; PCB designer compares every coordinate | Before GPS footprint assignment and placement approval |
| M02 | Nominal geometry verified; draft SSW carrier, uniform drills, courtyard and component keepout implemented/tested; installed access and retention remain open | Team/PCB designer fit [Teensy assembly](TEENSY_MECHANICAL_REVIEW.md) to chosen enclosure | Before Teensy mechanical approval |
| M03 | Exact socket/header configurations, tolerances, spacer/fastener part numbers and assembled height | PCB designer/team review this proposal with selected enclosure and hardware | Before placement freeze |
| M04 | Module revision photos, pin-one orientation, hole alignment, underside/access clearance, strain-free retention | Team dry-fit actual modules; record measurements and reviewer/date below | Before prototype fabrication approval |

Record for each module: product/revision ___; measurement method ___; header pitch/order ___; hole centers/diameters ___; carrier-to-module spacing ___; underside minimum gap ___; connector engagement ___; USB/SD/antenna/sensor access ___; retention ___; deviations ___; reviewer/date ___. For printed templates, verify a known dimension with a ruler before checking fit.

Unsent manufacturer question for M01: “Could you provide a dimensioned PCB drawing or CAD for Adafruit #5440 PA1616D GPS + GLONASS, including the current preinstalled battery-holder revision? We need header pad order and coordinates, mounting-hole centers/diameters, PCB outline/thickness, and antenna/underside component envelopes. The public Ultimate GPS board file we found identifies PA6H and dates from 2017. Please confirm which drawing matches #5440.” No inquiry has been sent.

Step 3's interface work and two sensor library contracts are ready for review. Mechanical sign-off remains open at M01–M04. **Step 4 interference/placement planning can proceed using draft envelopes**, with these constraints carried forward; final placement cannot be approved until the applicable gates close. Battery sizing and main ERC/DRC cleanup remain later work.
