mahruschow/team-pterodactyl/docs/validation/2026-10-21/first-prototype-release/aisler-bottom.png

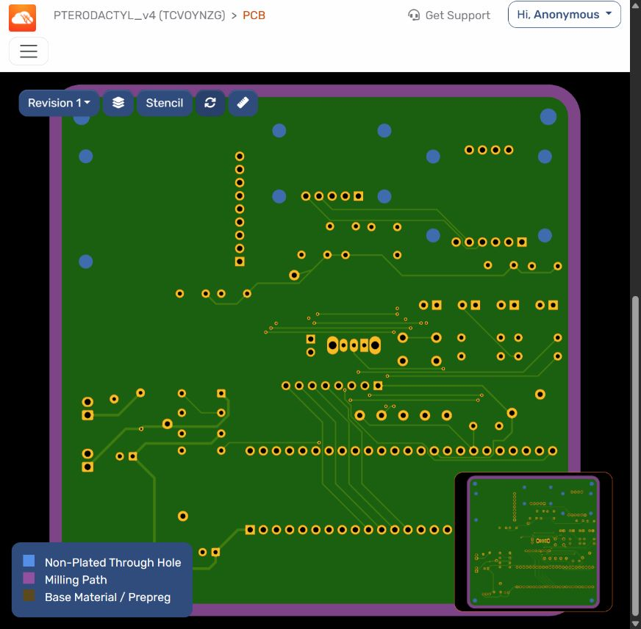
docs/validation/2026-10-21/first-prototype-release/aisler-bottom.png
