mahruschow/team-pterodactyl/docs/validation/2026-10-21/first-prototype-release/aisler-top.png

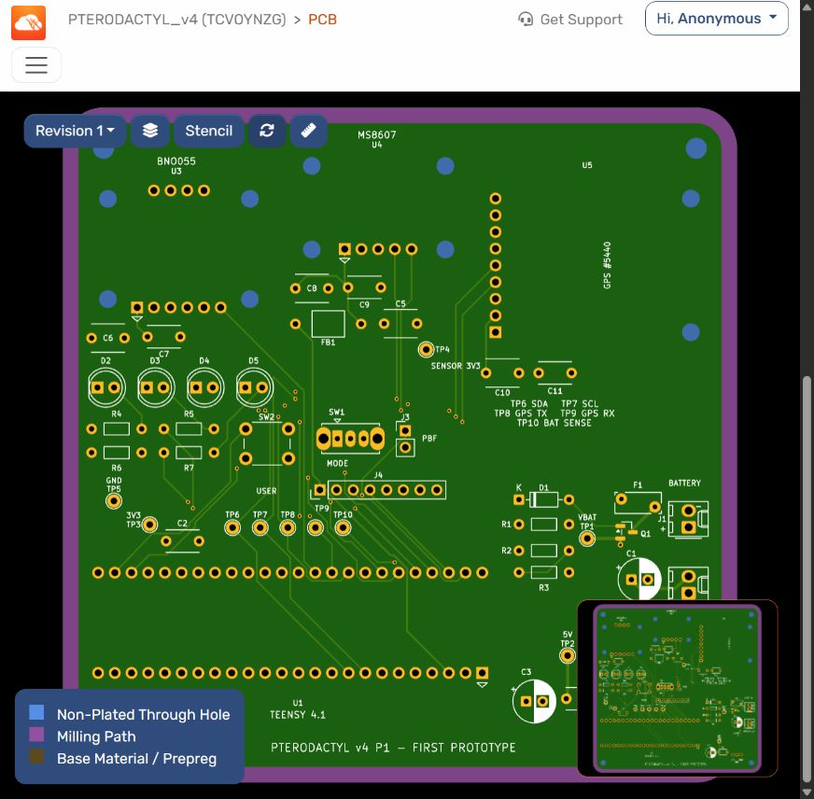
docs/validation/2026-10-21/first-prototype-release/aisler-top.png
