mahruschow/team-pterodactyl/docs/validation/2026-10-21/first-prototype-release/board-bottom-names.png

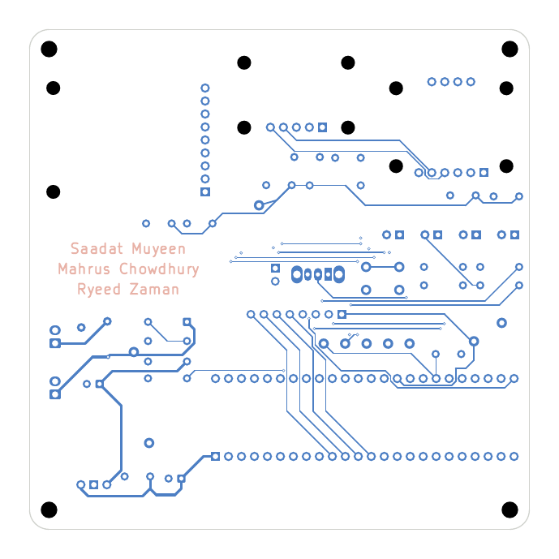
docs/validation/2026-10-21/first-prototype-release/board-bottom-names.png
