mahruschow/team-pterodactyl/docs/validation/2026-10-21/component-finalization/PTERODACTYL_v4.pdf

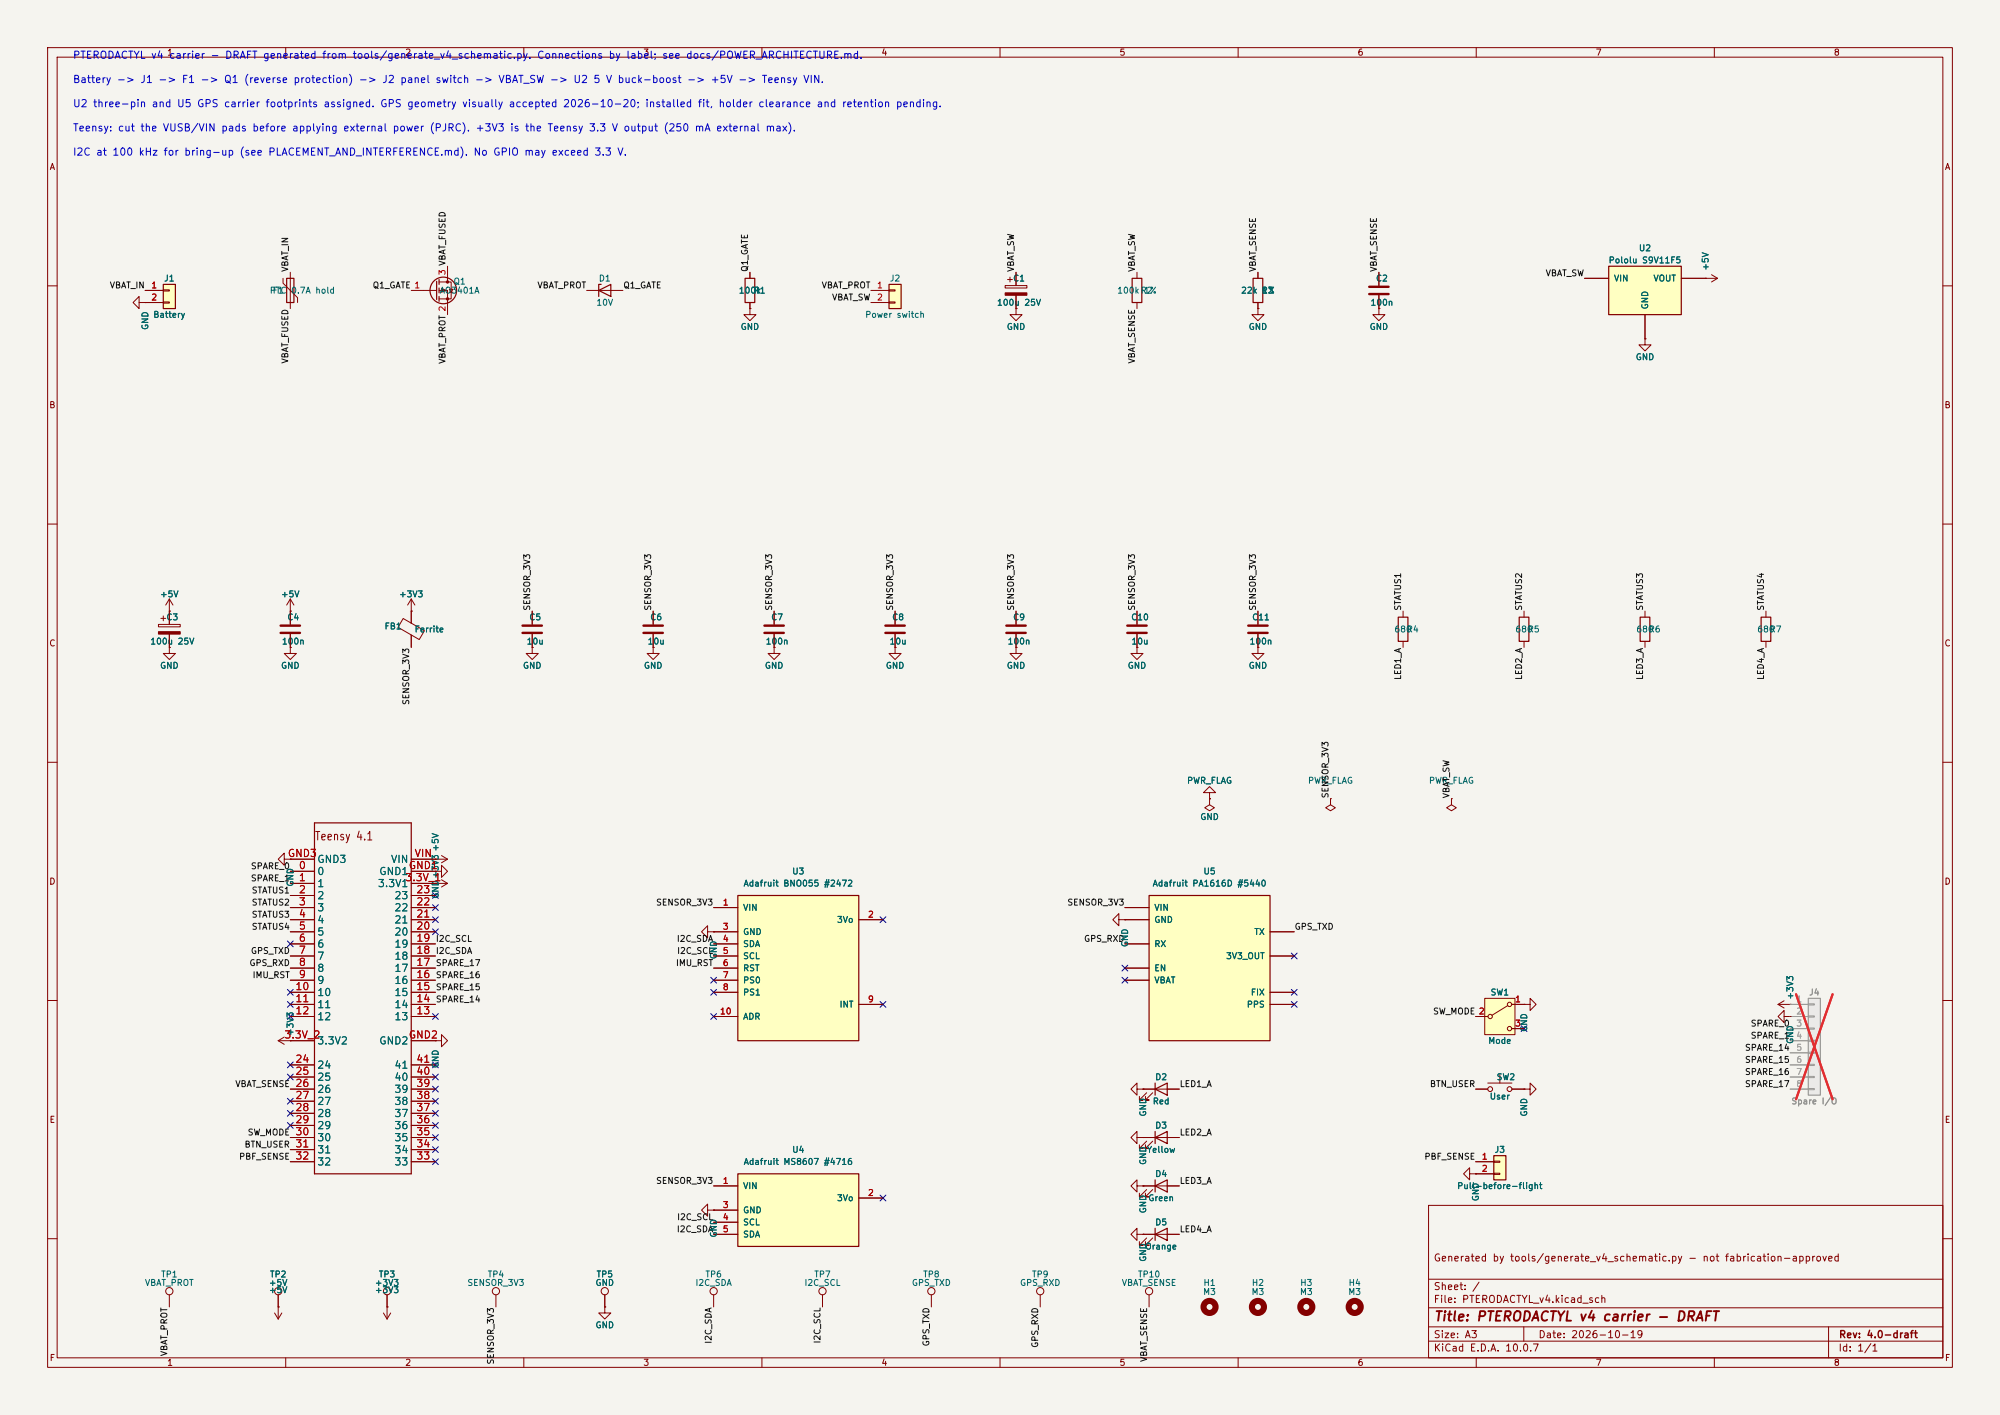
[picture p27: page 1]

PTERODACTYL v4 carrier - DRAFT generated from tools/generate_v4_schematic.py. Connections by label; see docs/POWER_ARCHITECTURE.md.
I2C_SCLI2C_SDA VBAT_FUSED

Battery -> J1 -> F1 -> Q1 (reverse protection) -> J2 panel switch -> VBAT_SW -> U2 5 V buck-boost -> +5V -> Teensy VIN.

U2 three-pin and U5 GPS carrier footprints assigned. GPS geometry visually accepted 2026-10-20; installed fit, holder clearance and retention pending.

Teensy: cut the VUSB/VIN pads before applying external power (PJRC). +3V3 is the Teensy 3.3 V output (250 mA external max).

Sheet: /
File: PTERODACTYL_v4.kicad_sch
Title: PTERODACTYL v4 carrier - DRAFT

Size: A3 | Rev: 4.0-draft | F Date: 2026-10-19
KiCad E.D.A. 10.0.7 | Id: 1/1
