mahruschow/team-pterodactyl/docs/validation/2026-10-21/first-prototype-release/assembly-top.pdf

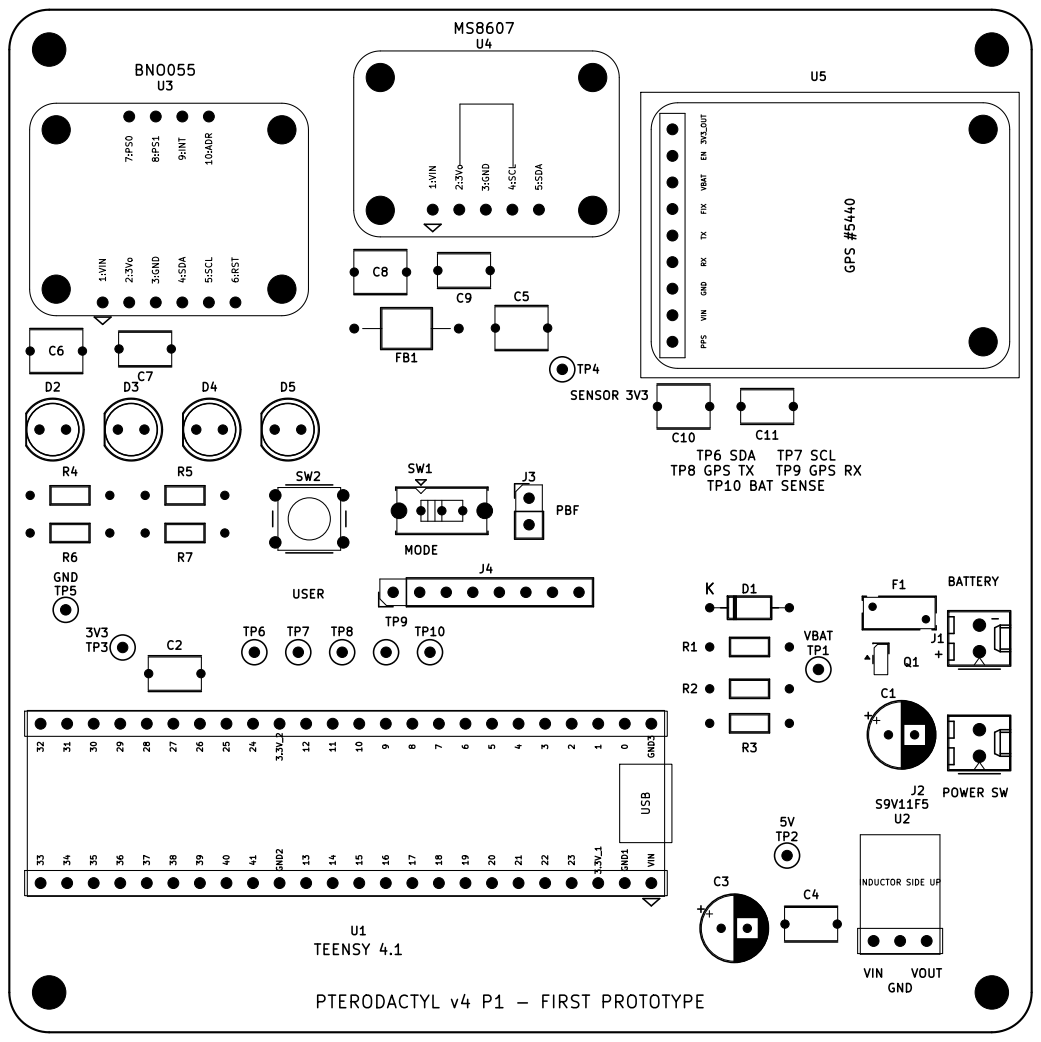
[picture p28: page 1]

MS8607 PTERODACTYL v4 P1 - FIRST PROTOTYPE
INDUCTOR SIDE UP 3V3_OUT EN VBAT FIX TX RX GND VIN PPS

0 GND1 USB GND3 VIN 1:VIN 7:PS0 2:3Vo 8:PS1 3:GND 9:INT 4:SDA 10:ADR 5:SCL 6:RST
