mahruschow/team-pterodactyl/docs/validation/2026-10-19/step7-pcb/v4-copper.pdf

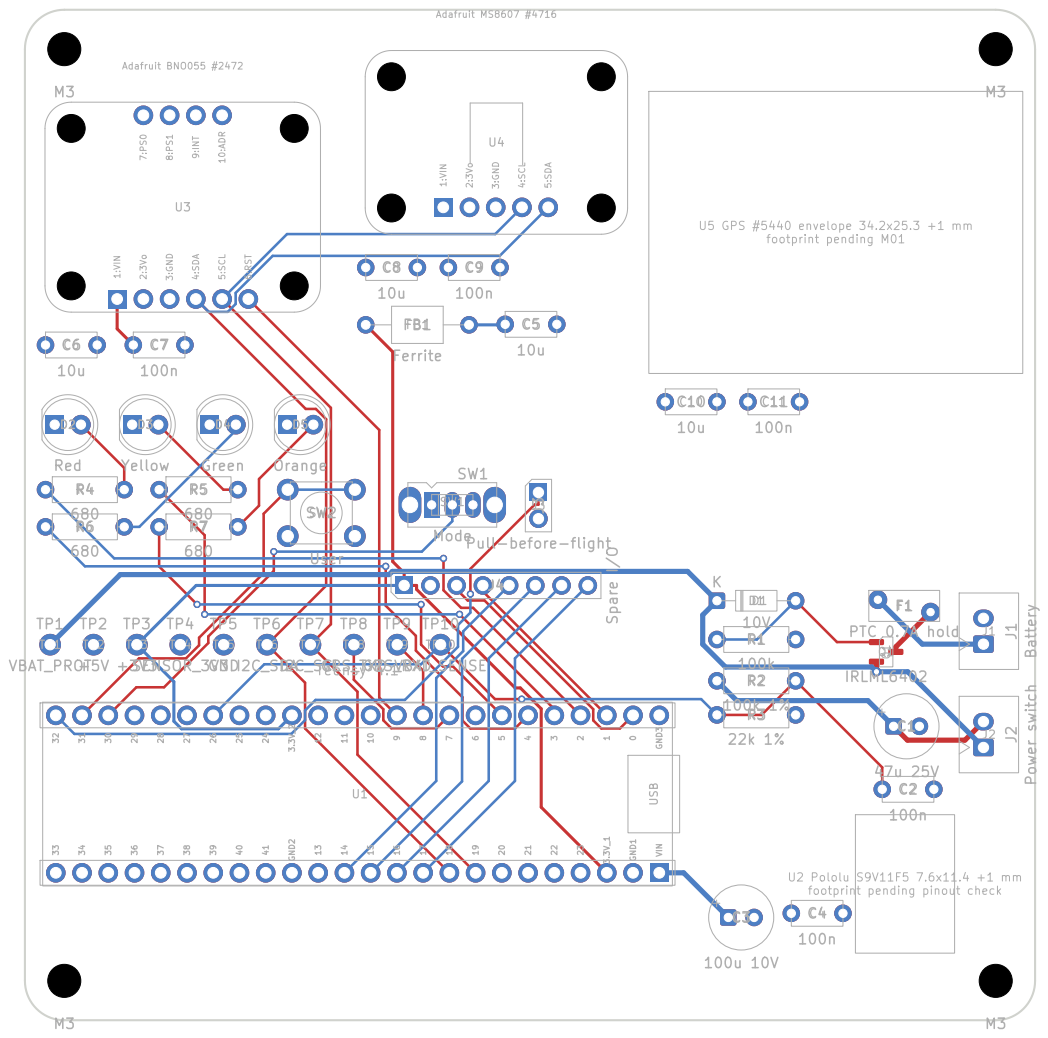
[picture p30: page 1]

footprint pending pinout check R2 100k 1%
