mahruschow/team-pterodactyl/docs/validation/2026-10-21/first-prototype-release/board-bottom-names.pdf

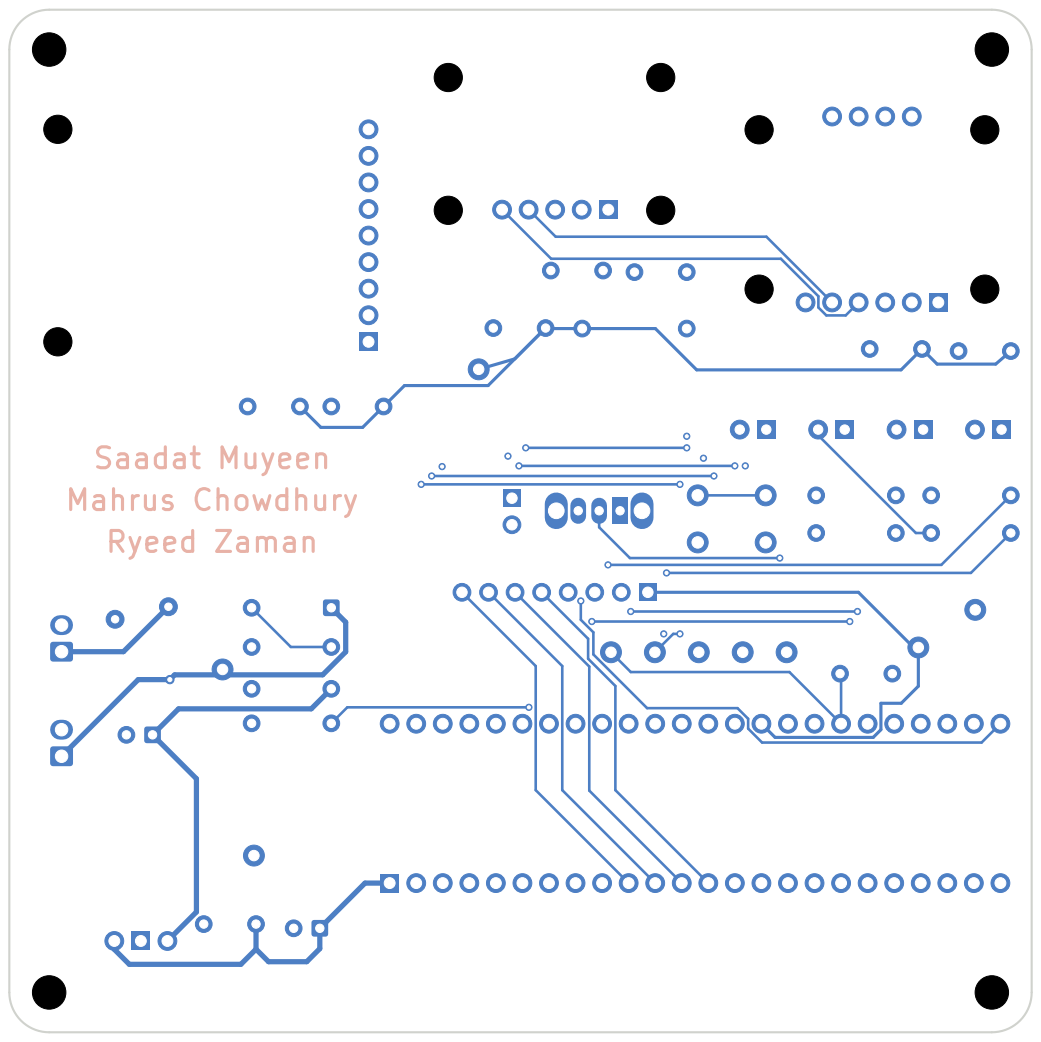
[picture p31: page 1]
