mahruschow/team-pterodactyl/docs/validation/2026-10-21/component-finalization/board-top-review.pdf

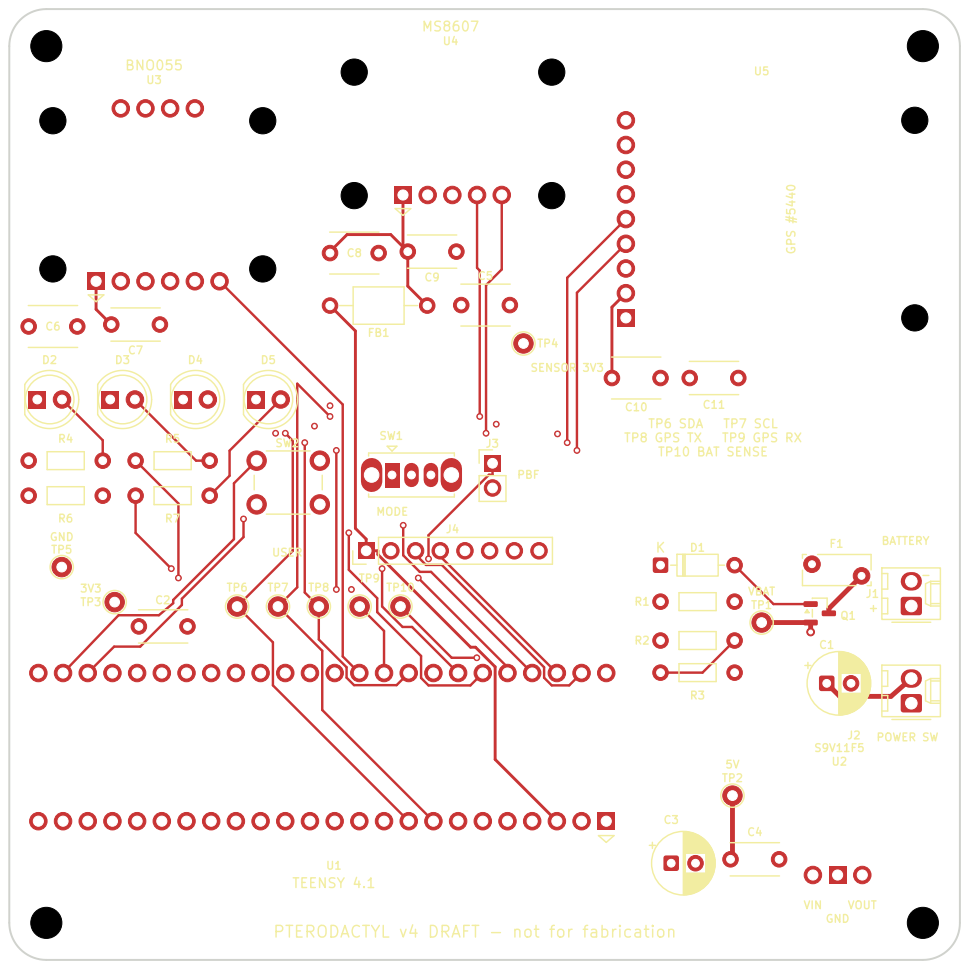
[picture p41: page 1]

PTERODACTYL v4 DRAFT - not for fabrication
