mahruschow/team-pterodactyl/docs/validation/2026-10-21/first-prototype-release/board-top.pdf

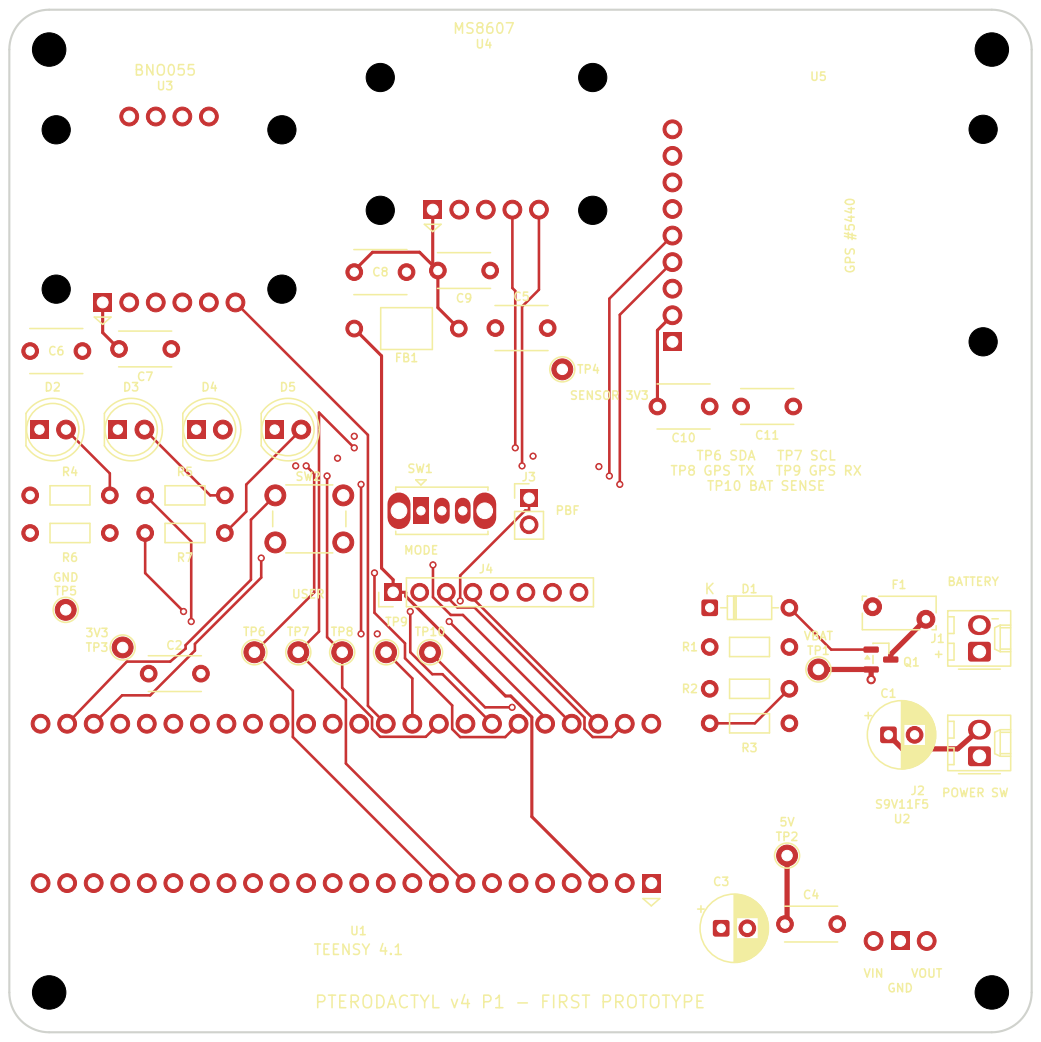
[picture p42: page 1]
