mahruschow/team-pterodactyl/(list of files, drawings)

Other design files:
docs/validation/2026-10-19/step5-schematic/schematic-check.json
docs/validation/2026-10-19/step7-pcb/pcb-check.json
docs/validation/2026-10-21/component-finalization/schematic-check.json
docs/validation/2026-10-21/first-prototype-release/schematic-check.json
