mahruschow/team-pterodactyl/Native_KiCad_v4/PTERODACTYL_v4.kicad_pcb

## KiCad design Native_KiCad_v4/PTERODACTYL_v4.kicad_pcb (2026-10-21, an earlier design)

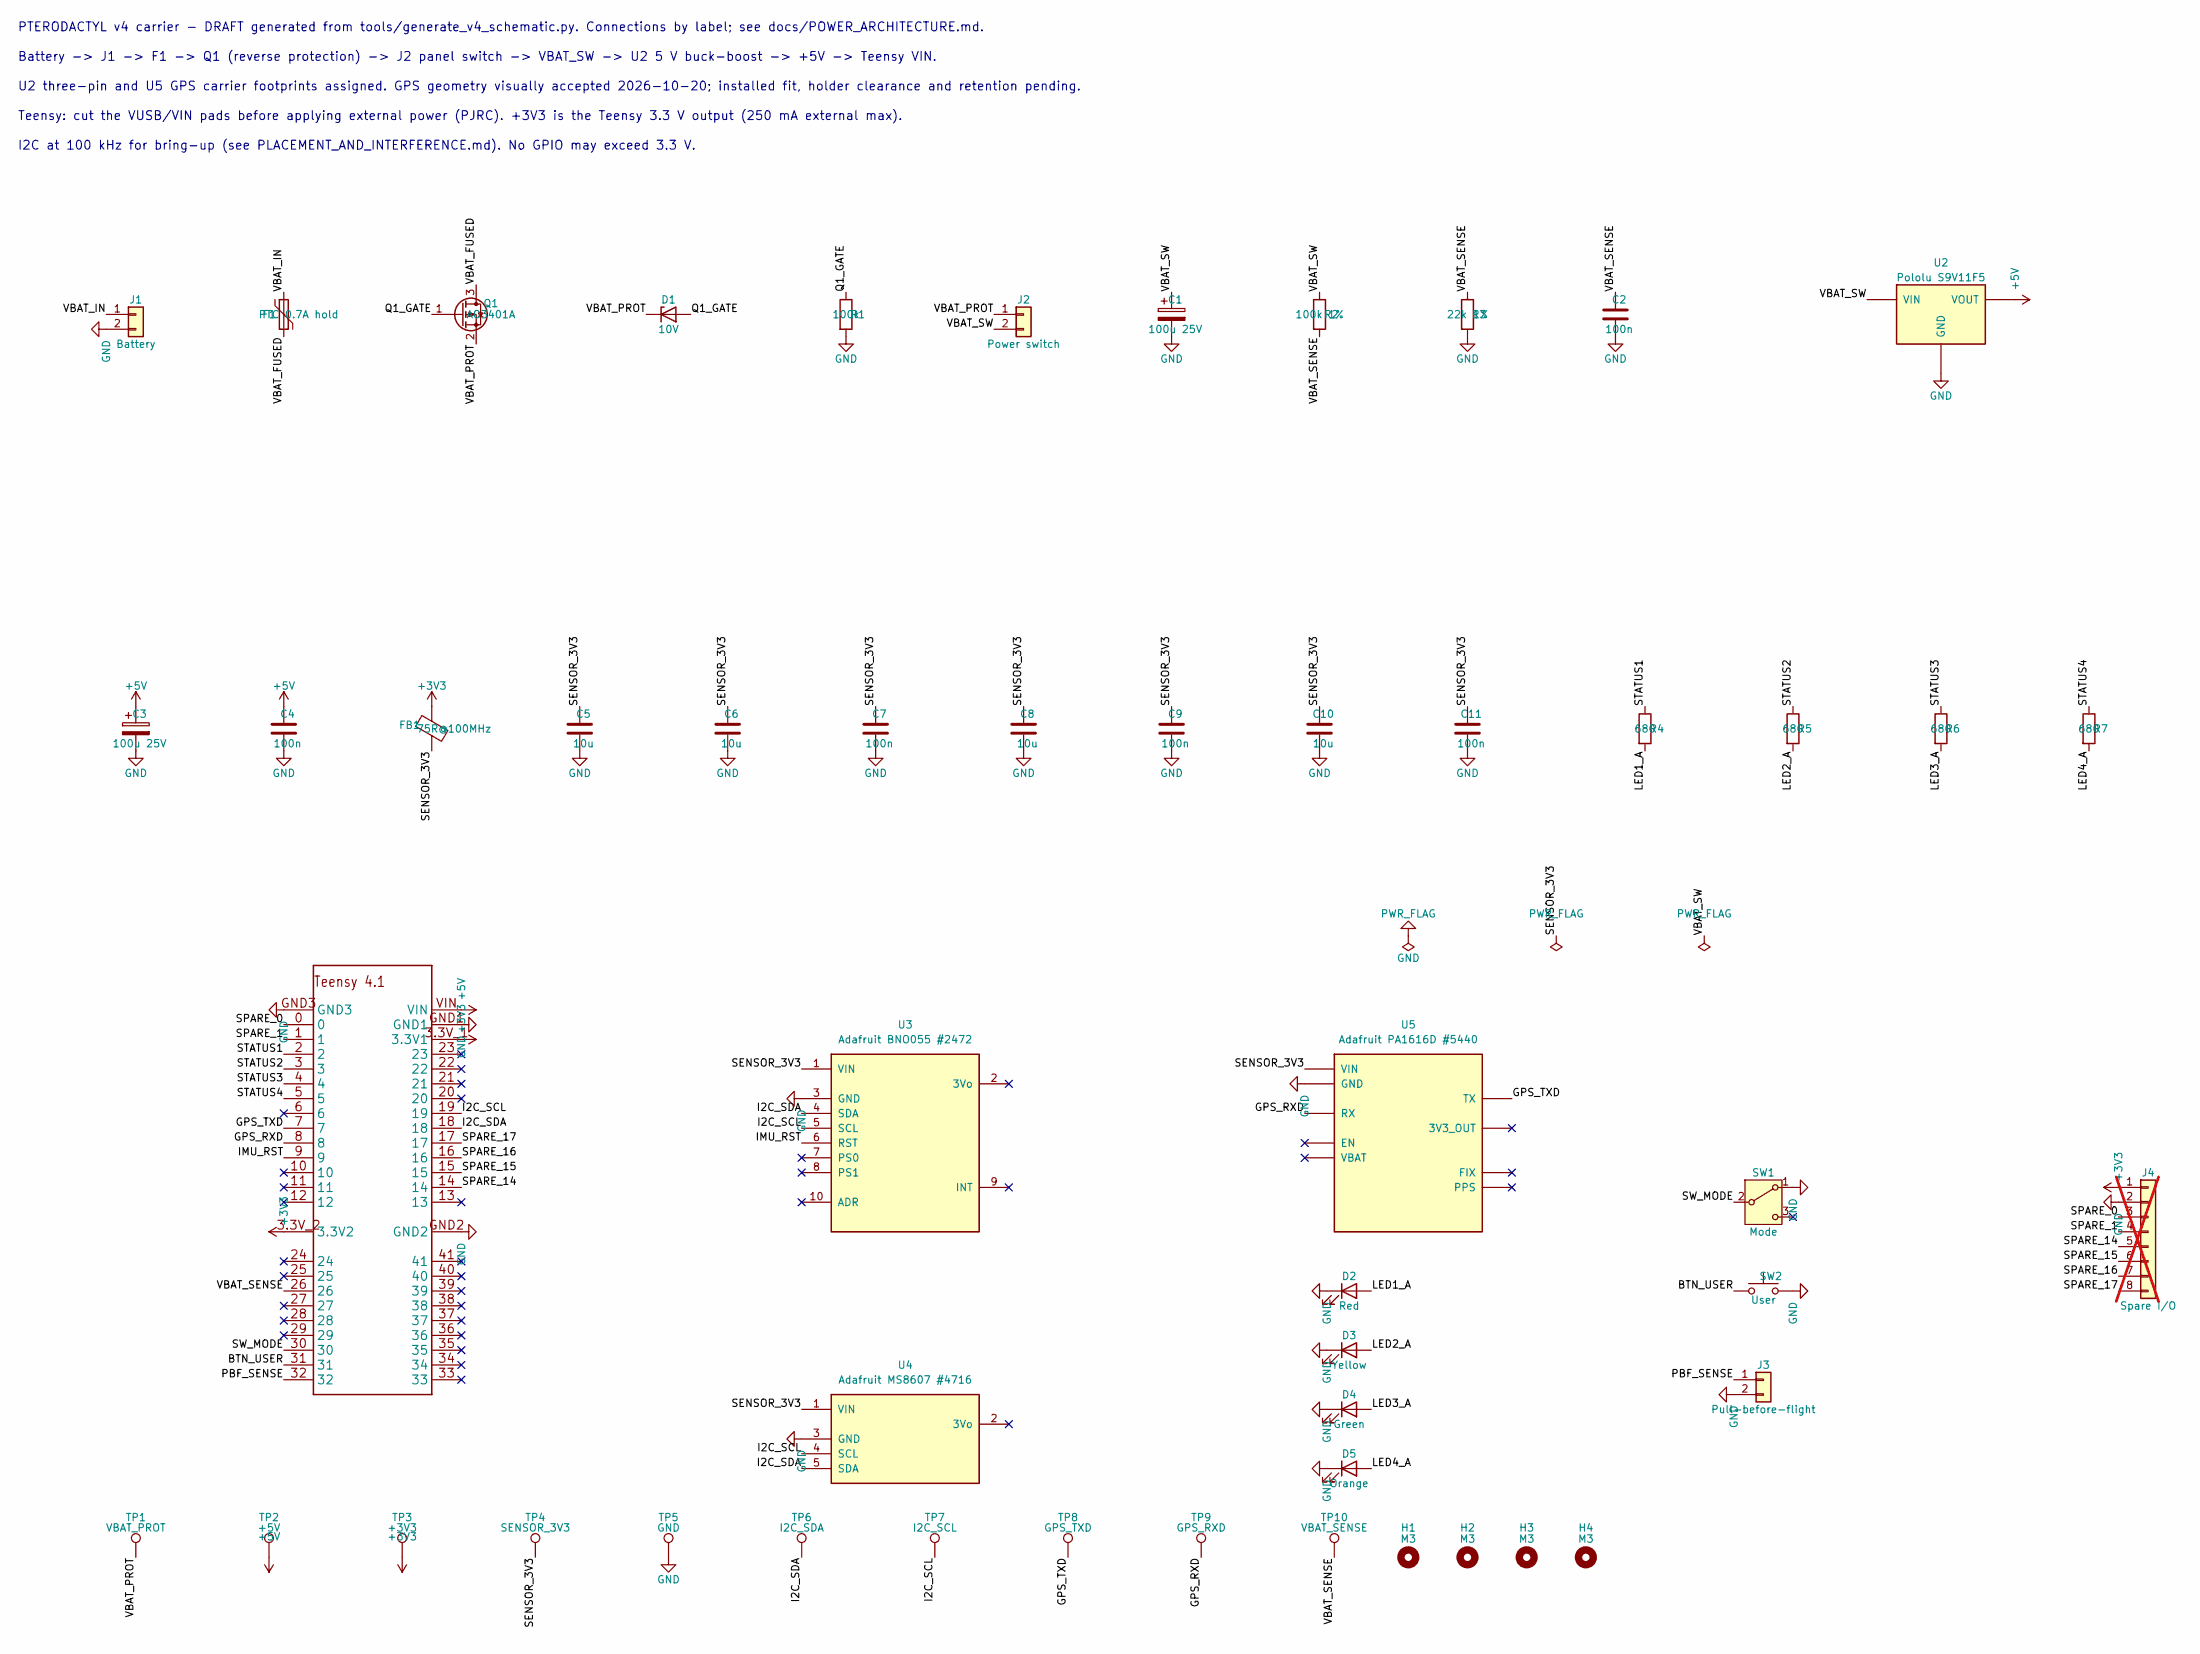
[picture p43: schematic PTERODACTYL_v4.kicad_sch, PTERODACTYL v4 carrier - DRAFT]

Parts:
C1, C3: 100u 25V; Panasonic_EEUFR1E101_P2.50mm; MPN EEUFR1E101
C2, C4, C7, C9, C11: 100n; KEMET_C322_100n_P5.00mm; MPN C322C104K5R5TA
C5, C6, C8, C10: 10u; KEMET_C322_10u_P5.00mm; MPN C322C106K3R5TA
D1: 10V; D_DO-35_SOD27_P7.62mm_Horizontal; MPN BZX79-C10,133
D2: Red; LED_D5.0mm; MPN WP7113LID
D3: Yellow; LED_D5.0mm; MPN WP7113LYD
D4: Green; LED_D5.0mm; MPN WP7113LGD
D5: Orange; LED_D5.0mm; MPN WP7113LSECK/J4
F1: PTC 0.7A hold; Fuse_Bourns_MF-RHT070; MPN MF-RHT070-0
FB1: 75R@100MHz; Laird_28L0138_P10.00mm; MPN 28L0138-10R-10
H1, H2, H3, H4: M3; MountingHole_3.2mm_M3
J1: Battery; Molex_0022272021_AISLER; MPN 0022272021
J2: Power switch; Molex_0022272021_AISLER; MPN 0022272021
J3: Pull-before-flight; PinHeader_1x02_P2.54mm_Vertical; MPN HTSW-102-07-T-S
J4: Spare I/O; PinHeader_1x08_P2.54mm_Vertical; MPN DNP; not fitted
Q1: AO3401A; AO3401A_SOT23_AISLER; MPN AO3401A
R1: 100k; Vishay_MRS16_P7.62mm; MPN MRS16000C1003FCT00
R2: 100k 1%; Vishay_MRS16_P7.62mm; MPN MRS16000C1003FCT00
R3: 22k 1%; Vishay_MRS16_P7.62mm; MPN MRS16000C2202FCT00
R4, R5, R6, R7: 680; Vishay_MRS16_P7.62mm; MPN MRS16000C6800FCT00
SW1: Mode; SW_Slide_SPDT_Straight_CK_OS102011MS2Q; MPN OS102011MS2QN1
SW2: User; SW_PUSH_6mm; MPN PTS645SL50-2 LFS
TP1: VBAT_PROT; TestPoint_THTPad_D2.0mm_Drill1.0mm; MPN PCB PAD ONLY
TP2: +5V; TestPoint_THTPad_D2.0mm_Drill1.0mm; MPN PCB PAD ONLY
TP3: +3V3; TestPoint_THTPad_D2.0mm_Drill1.0mm; MPN PCB PAD ONLY
TP4: SENSOR_3V3; TestPoint_THTPad_D2.0mm_Drill1.0mm; MPN PCB PAD ONLY
TP5: GND; TestPoint_THTPad_D2.0mm_Drill1.0mm; MPN PCB PAD ONLY
TP6: I2C_SDA; TestPoint_THTPad_D2.0mm_Drill1.0mm; MPN PCB PAD ONLY
TP7: I2C_SCL; TestPoint_THTPad_D2.0mm_Drill1.0mm; MPN PCB PAD ONLY
TP8: GPS_TXD; TestPoint_THTPad_D2.0mm_Drill1.0mm; MPN PCB PAD ONLY
TP9: GPS_RXD; TestPoint_THTPad_D2.0mm_Drill1.0mm; MPN PCB PAD ONLY
TP10: VBAT_SENSE; TestPoint_THTPad_D2.0mm_Drill1.0mm; MPN PCB PAD ONLY
U1: Teensy 4.1; Teensy41_SSW_Carrier; MPN PJRC Teensy 4.1
U2: Pololu S9V11F5; Pololu_S9V11F5_SSW_Carrier; MPN Pololu #2836
U3: Adafruit BNO055 #2472; Adafruit_BNO055_2472_Carrier; MPN Adafruit 2472
U4: Adafruit MS8607 #4716; Adafruit_MS8607_4716_Carrier; MPN Adafruit 4716
U5: Adafruit PA1616D #5440; Adafruit_GPS_5440_Carrier; MPN Adafruit 5440

Connections:
+3V3: FB1.1, J4.1, TP3.1, U1.3.3V_1 (3.3V1), U1.3.3V_2 (3.3V2)
+5V: C3.1, C4.1, TP2.1, U1.VIN, U2.VOUT
/BTN_USER: SW2.1, U1.31
/GPS_RXD: TP9.1, U1.8, U5.RX
/GPS_TXD: TP8.1, U1.7, U5.TX
/I2C_SCL: TP7.1, U1.19, U3.5 (SCL), U4.4 (SCL)
/I2C_SDA: TP6.1, U1.18, U3.4 (SDA), U4.5 (SDA)
/IMU_RST: U1.9, U3.6 (RST)
/LED1_A: D2.2 (A), R4.2
/LED2_A: D3.2 (A), R5.2
/LED3_A: D4.2 (A), R6.2
/LED4_A: D5.2 (A), R7.2
/PBF_SENSE: J3.1, U1.32
/Q1_GATE: D1.2 (A), Q1.1 (G), R1.1
/SENSOR_3V3: C5.1, C6.1, C7.1, C8.1, C9.1, C10.1, C11.1, FB1.2, TP4.1, U3.1 (VIN), U4.1 (VIN), U5.VIN
/SPARE_0: J4.3, U1.0
/SPARE_1: J4.4, U1.1
/SPARE_14: J4.5, U1.14
/SPARE_15: J4.6, U1.15
/SPARE_16: J4.7, U1.16
/SPARE_17: J4.8, U1.17
/STATUS1: R4.1, U1.2
/STATUS2: R5.1, U1.3
/STATUS3: R6.1, U1.4
/STATUS4: R7.1, U1.5
/SW_MODE: SW1.2 (B), U1.30
/VBAT_FUSED: F1.2, Q1.3 (D)
/VBAT_IN: F1.1, J1.1
/VBAT_PROT: D1.1 (K), J2.1, Q1.2 (S), TP1.1
/VBAT_SENSE: C2.1, R2.2, R3.1, TP10.1, U1.26
/VBAT_SW: C1.1, J2.2, R2.1, U2.VIN
GND: C1.2, C2.2, C3.2, C4.2, C5.2, C6.2, C7.2, C8.2, C9.2, C10.2, C11.2, D2.1 (K), D3.1 (K), D4.1 (K), D5.1 (K), J1.2, J3.2, J4.2, R1.2, R3.2, SW1.1 (A), SW2.2, TP5.1, U1.GND1, U1.GND2, U1.GND3, U2.GND, U3.3 (GND), U4.3 (GND), U5.GND

Notes on the sheet:
PTERODACTYL v4 carrier - DRAFT generated from tools/generate_v4_schematic.py. Connections by label; see docs/POWER_ARCHITECTURE.md.
Battery -> J1 -> F1 -> Q1 (reverse protection) -> J2 panel switch -> VBAT_SW -> U2 5 V buck-boost -> +5V -> Teensy VIN.
U2 three-pin and U5 GPS carrier footprints assigned. GPS geometry visually accepted 2026-10-20; installed fit, holder clearance and retention pending.
Teensy: cut the VUSB/VIN pads before applying external power (PJRC). +3V3 is the Teensy 3.3 V output (250 mA external max).
I2C at 100 kHz for bring-up (see PLACEMENT_AND_INTERFERENCE.md). No GPIO may exceed 3.3 V.

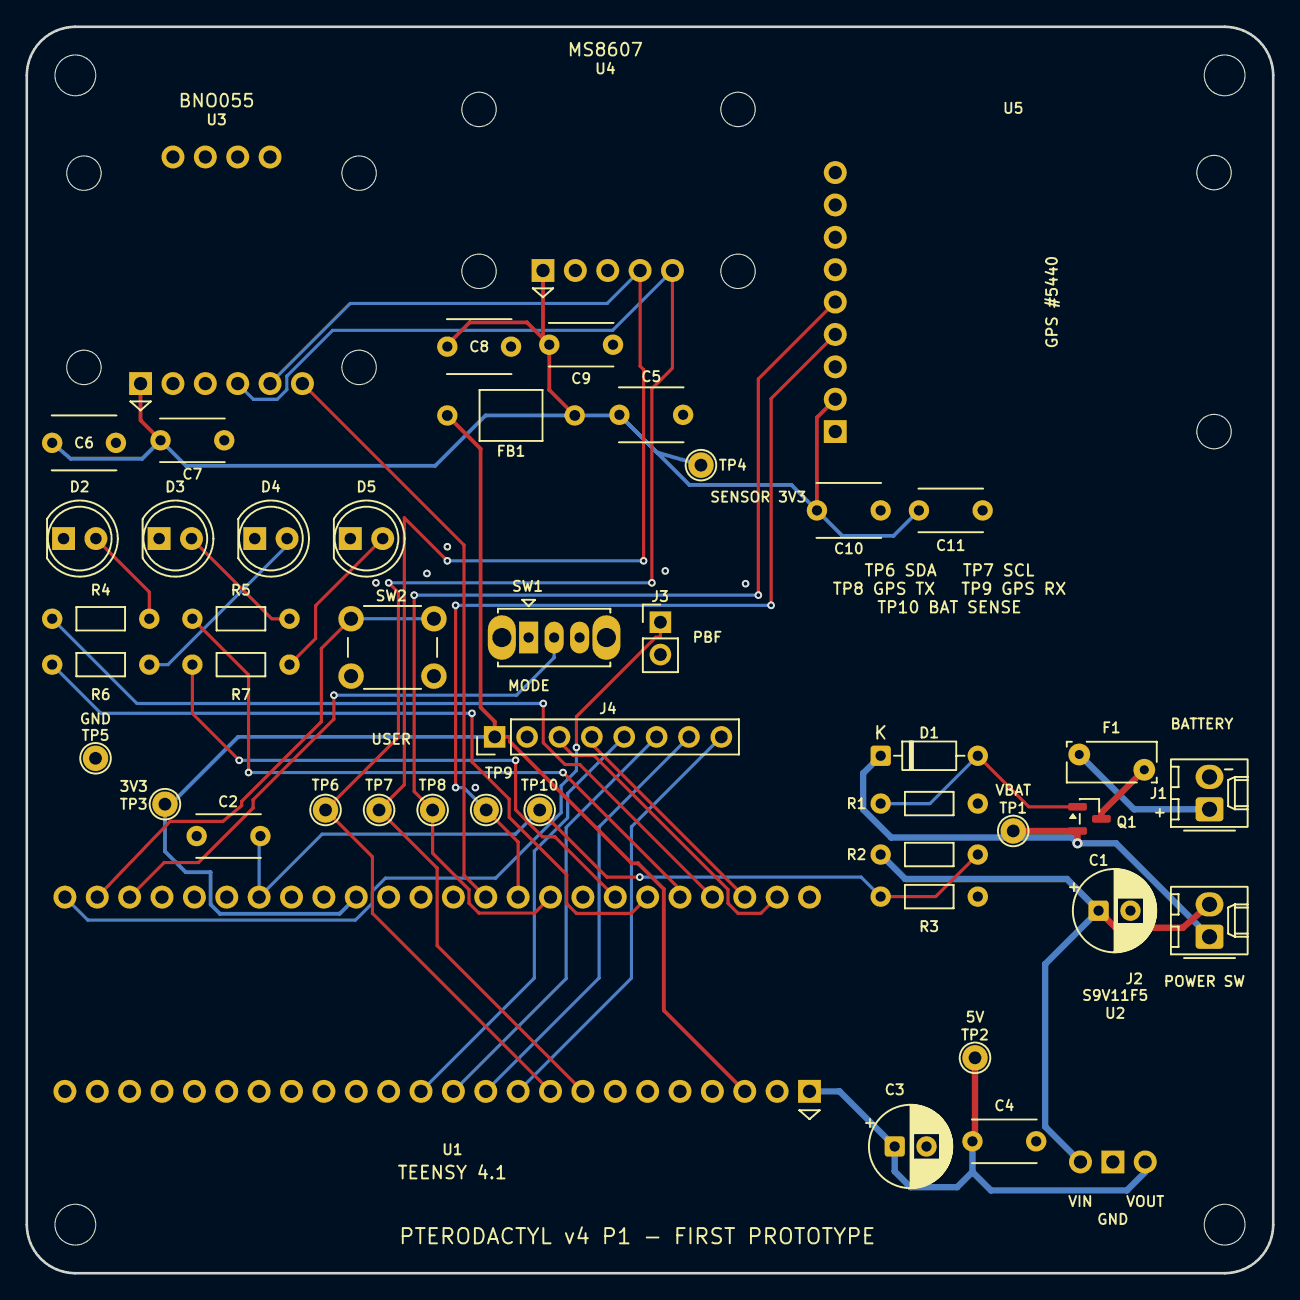
[picture p44: board PTERODACTYL_v4.kicad_pcb from above]

Board: 4 copper layers, 97.8 x 97.8 mm, 51 parts (0 on the bottom side), 32 nets.
