mahruschow/team-pterodactyl/Original_Fusion_source/PTERODACTYL_v3.8_v11.brd

## EAGLE design Original_Fusion_source/PTERODACTYL_v3.8_v11.brd (2026-10-14)

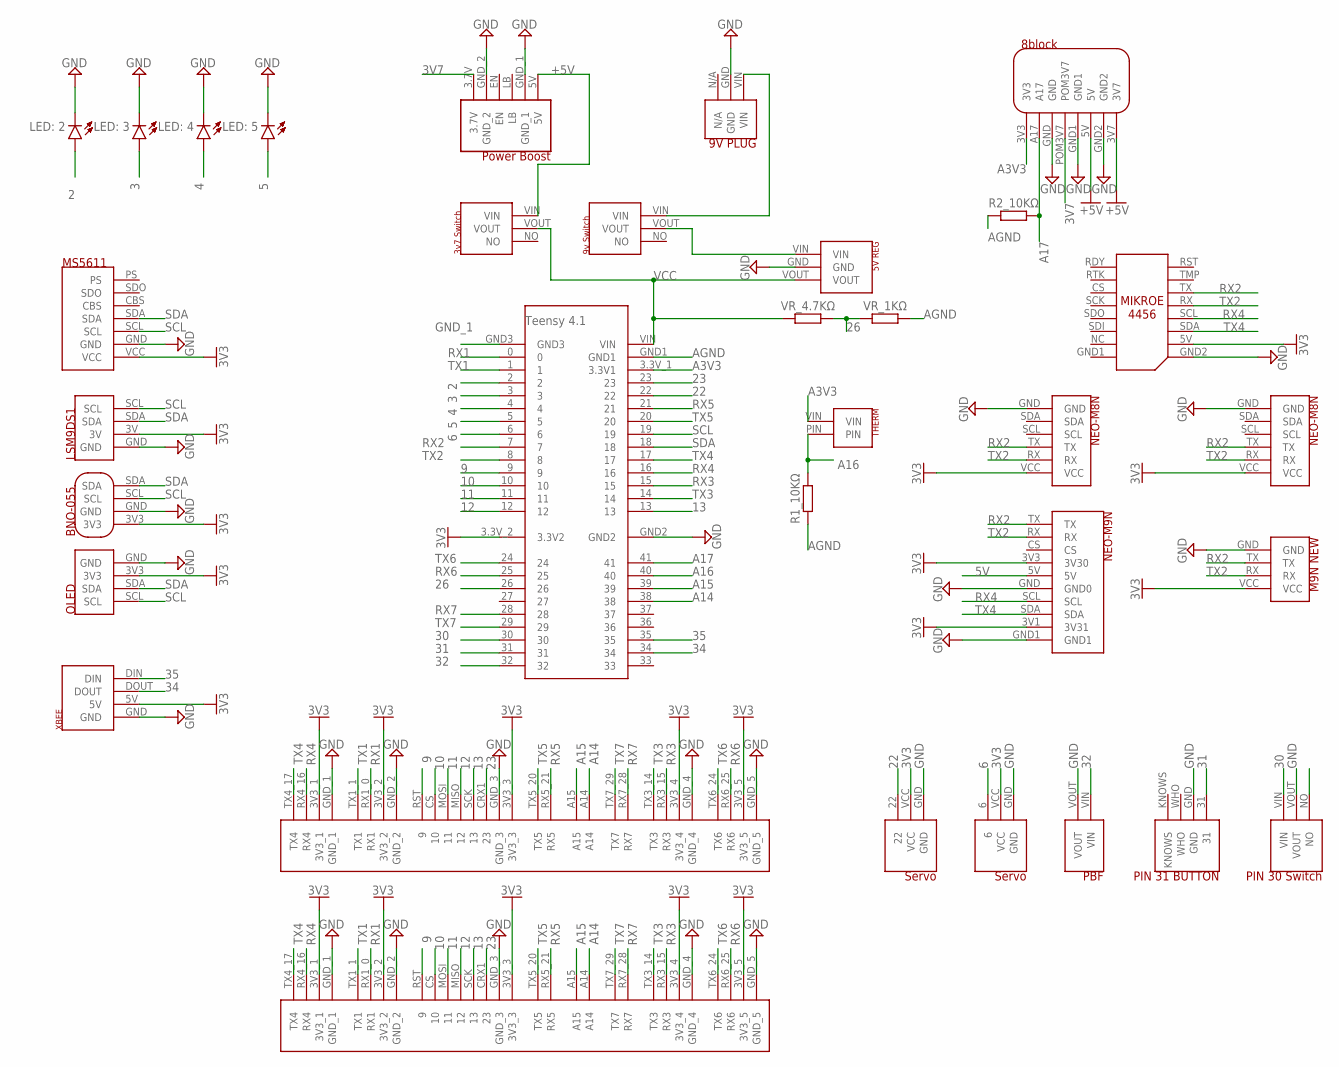
[picture p48: schematic PTERODACTYL_v3.8_v11.sch]

Parts:
D1: LED: 3; LEDRD254W60D565H860B_W
D2: LED: 4; LEDRD254W60D565H860B
D3: LED: 5; LEDRD254W60D565H860B_B
D4: LED: 2; LEDRD254W60D565H860B_Y
R1_10KΩ, R2_10KΩ: R_AXIAL-11.7MM-PITCH; RESAD1176W63L850D250B
U$1: FEMALE_HEADERS_V1.3
U$2: TERMINAL_BLOCK_V1.3
U$3: TEENSY41_SIMPLE
U$4: PT8BLOCK; PTERODACTYL8BLOCK
U$5: 5VREG
U$6: 3V7SWITCH
U$7: 9VSWITCH
U$8: 9VPLUG
U$9: OLED_SIMPLE
U$10: LSM9DS1_SIMPLE
U$11: MS5611
U$12: UBLOXM8NTERMINAL
U$13: UBLOXM8NSIMPLE
U$14: XBEE_SIMPLE
U$15: UBLOXM9NSIMPLE
U$16: THERMISTOR10K1; THERMISTOR10K
U$17: BNO055
U$22: UBLOXM9N_NEW_SIMPLE
U$23: SERVO; PIN6SERVO
U$24: PBF; PULLBEFOREFLIGHT
U$25: BUTTON; PIN31BUTTON
U$26: PIN30SWITCH
U$27: SERVO22; PI22SERVO
U$28: POWERBOOST; 5VPOWERBOOST
U$29: MIKROE
VR_1KΩ, VR_4.7KΩ: R_AXIAL-11.7MM-PITCH; RESAD1176W63L850D250B

Connections:
2: D4.1 (A), U$3.2
3: D1.1 (A), U$3.3
3V3: U$1.3V3_1, U$1.3V3_2, U$1.3V3_3, U$1.3V3_4, U$1.3V3_5, U$2.3V3_1, U$2.3V3_2, U$2.3V3_3, U$2.3V3_4, U$2.3V3_5, U$3.3.3V_2 (3.3V2), U$9.3V3, U$10.3V, U$11.VCC, U$12.VCC, U$13.VCC, U$14.5V, U$15.3V1 (3V31), U$15.3V3 (3V30), U$17.3V3, U$22.VCC, U$23.VCC, U$27.VCC, U$29.5V
3V7: U$4.POM3V7, U$28.3.7V
4: D2.1 (A), U$3.4
5: D3.1 (A), U$3.5
5V: U$15.5V
6: U$3.6, U$23.6
9: U$1.RST (9), U$2.RST (9), U$3.9
10: U$1.CS (10), U$2.CS (10), U$3.10
11: U$1.MOSI (11), U$2.MOSI (11), U$3.11
12: U$1.MISO (12), U$2.MISO (12), U$3.12
13: U$1.SCK (13), U$2.SCK (13), U$3.13
22: U$3.22, U$27.22
23: U$1.CRX1 (23), U$2.CRX1 (23), U$3.23
26: U$3.26, VR_1KΩ.1, VR_4.7KΩ.2
30: U$3.30, U$26.VIN
31: U$3.31, U$25.31
32: U$3.32, U$24.VIN
34: U$3.34, U$14.DOUT
35: U$3.35, U$14.DIN
+5V: U$4.3V7, U$4.5V, U$6.VIN, U$28.5V
A3V3: U$3.3.3V_1 (3.3V1), U$4.3V3, U$16.VIN
A14: U$1.A14, U$2.A14, U$3.38
A15: U$1.A15, U$2.A15, U$3.39
A16: R1_10KΩ.2, U$3.40, U$16.PIN
A17: R2_10KΩ.2, U$3.41, U$4.A17
AGND: R1_10KΩ.1, R2_10KΩ.1, U$3.GND1, VR_1KΩ.2
GND: D1.2 (C), D2.2 (C), D3.2 (C), D4.2 (C), U$1.GND_1, U$1.GND_2, U$1.GND_3, U$1.GND_4, U$1.GND_5, U$2.GND_1, U$2.GND_2, U$2.GND_3, U$2.GND_4, U$2.GND_5, U$3.GND2, U$4.GND, U$4.GND1, U$4.GND2, U$5.GND, U$8.GND, U$9.GND, U$10.GND, U$11.GND, U$12.GND, U$13.GND, U$14.GND, U$15.GND (GND0), U$15.GND1, U$17.GND, U$22.GND, U$23.GND, U$24.VOUT, U$25.GND, U$26.VOUT, U$27.GND, U$28.GND_1, U$28.GND_2, U$29.GND2
GND_1: U$3.GND3
RX1: U$1.RX1_0 (RX1), U$2.RX1_0 (RX1), U$3.0
RX2: U$3.7, U$12.TX, U$13.TX, U$15.TX, U$22.TX, U$29.TX
RX3: U$1.RX3_15 (RX3), U$2.RX3_15 (RX3), U$3.15
RX4: U$1.RX4_16 (RX4), U$2.RX4_16 (RX4), U$3.16, U$15.SCL, U$29.SCL
RX5: U$1.RX5_21 (RX5), U$2.RX5_21 (RX5), U$3.21
RX6: U$1.RX6_25 (RX6), U$2.RX6_25 (RX6), U$3.25
RX7: U$1.RX7_28 (RX7), U$2.RX7_28 (RX7), U$3.28
SCL: U$3.19, U$9.SCL, U$10.SCL, U$11.SCL, U$17.SCL
SDA: U$3.18, U$9.SDA, U$10.SDA, U$11.SDA, U$17.SDA
TX1: U$1.TX1_1 (TX1), U$2.TX1_1 (TX1), U$3.1
TX2: U$3.8, U$12.RX, U$13.RX, U$15.RX, U$22.RX, U$29.RX
TX3: U$1.TX3_14 (TX3), U$2.TX3_14 (TX3), U$3.14
TX4: U$1.TX4_17 (TX4), U$2.TX4_17 (TX4), U$3.17, U$15.SDA, U$29.SDA
TX5: U$1.TX5_20 (TX5), U$2.TX5_20 (TX5), U$3.20
TX6: U$1.TX6_24 (TX6), U$2.TX6_24 (TX6), U$3.24
TX7: U$1.TX7_29 (TX7), U$2.TX7_29 (TX7), U$3.29
VCC: U$3.VIN, U$5.VOUT, U$6.VOUT, VR_4.7KΩ.1
VCC_2: U$7.VIN, U$8.VIN
VCC_3: U$5.VIN, U$7.VOUT

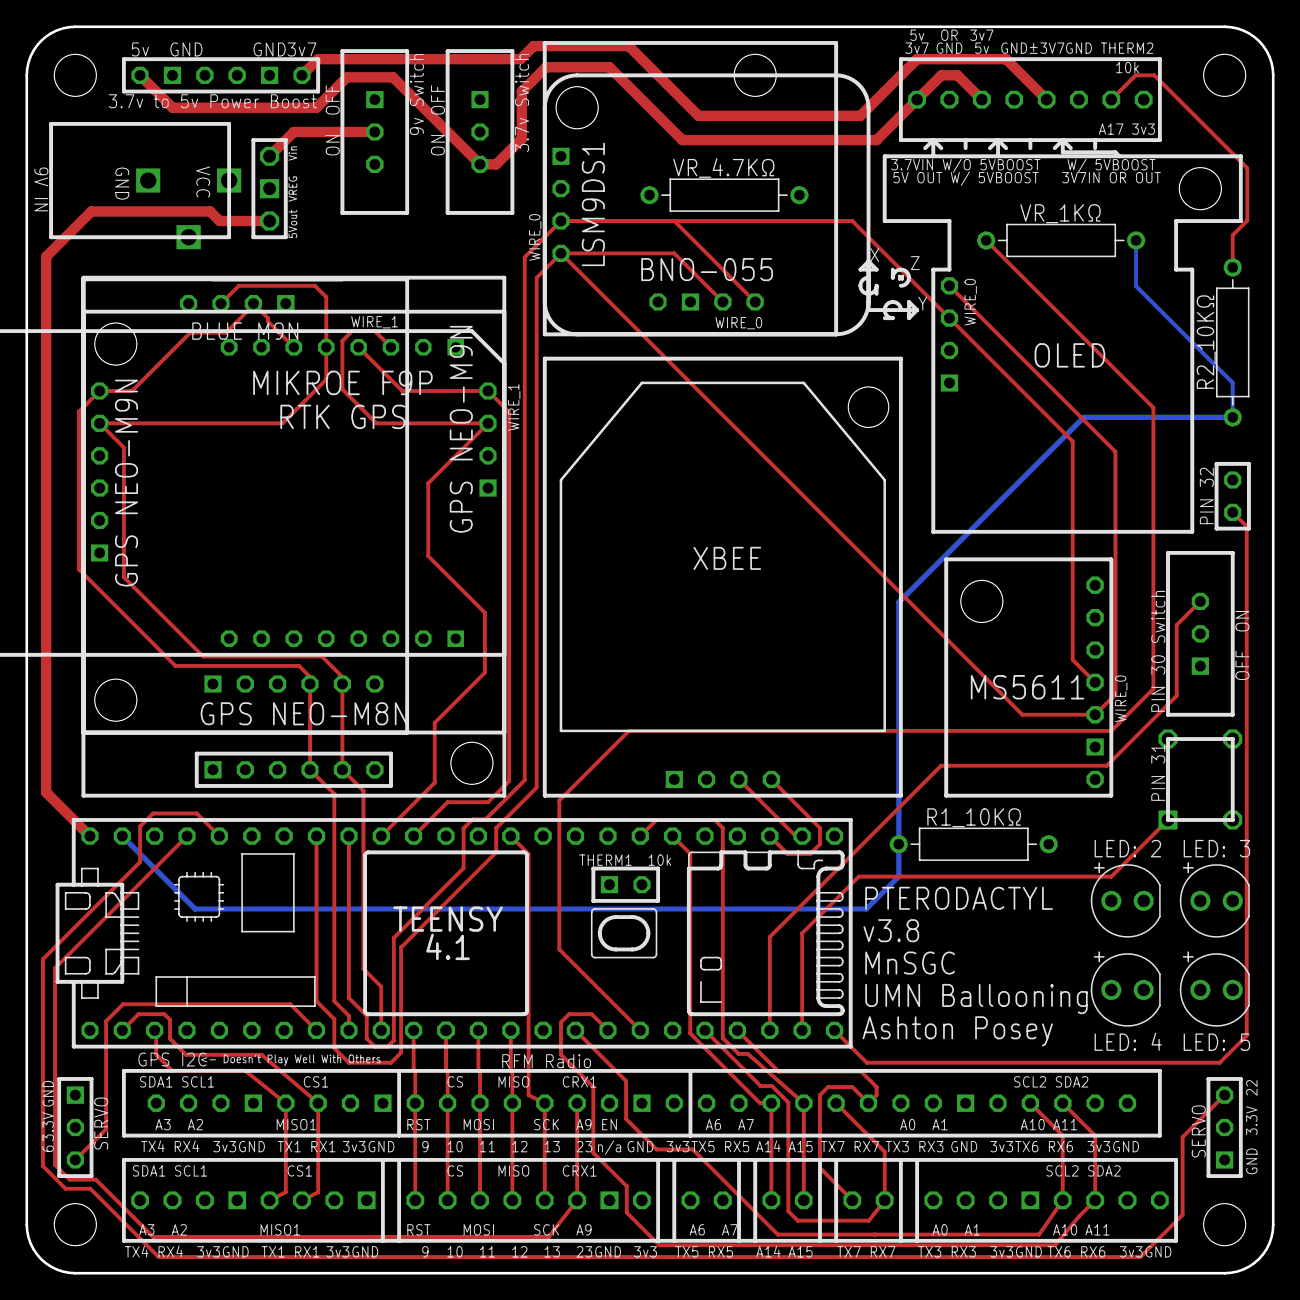
[picture p49: board PTERODACTYL_v3.8_v11.brd from above]

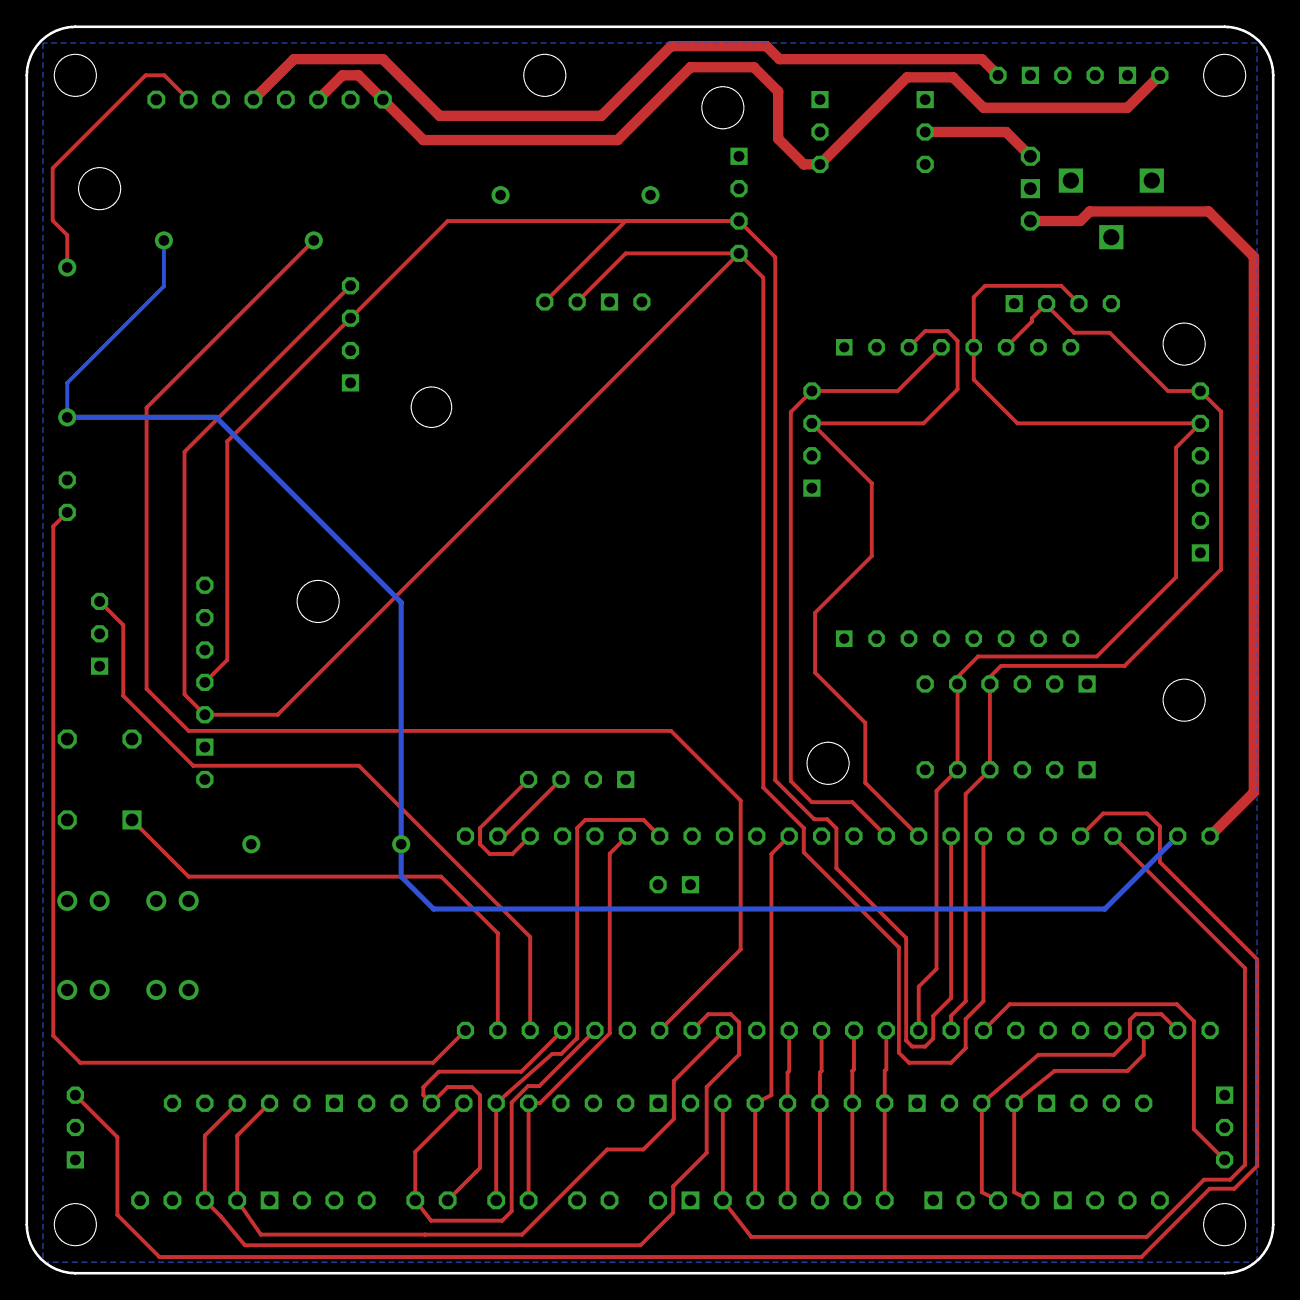
[picture p50: board PTERODACTYL_v3.8_v11.brd from below]

Board: 4 copper layers, 97.8 x 97.8 mm, 39 parts (4 on the bottom side), 47 nets.

Other parts of the board:
U$18, U$19, U$20, U$21: HOLE
U$30: PTERODACTYLV3.1
U$32: AXIS
