mahruschow/team-pterodactyl/(commit log)

2026-10-14 Add PTERODACTYL KiCad design baseline and references
    [PTERODACTYL_v3.8_v11.brd, PTERODACTYL_v3.8_v11.f3z, PTERODACTYL_v3.8_v11.kicad_pcb, PTERODACTYL_v3.8_v11.kicad_sch, PTERODACTYL_v3.8_v11.sch]
2026-10-18 docs: add team handoff, development requirements and KiCad baseline audit
    Create a shared docs directory so teammates and future sessions can resume
    the PTERODACTYL redesign without relying on prior chat history.
    Add:
    - A documentation index, current-status/resume checklist and dated session
    notes covering completed work, limitations, decisions and next actions.
    - A ten-step development plan from baseline review through prototype tests
    and flight release, including interference and mechanical-fit reviews.
    - Version-one requirements with retained/replaced/optional hardware,
    proposed sampling and logging behavior, acceptance checks, and an open
    decision register with dependency deadli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
    [Budgets_2026-10-18.xlsx]
2026-10-19 feat(hardware): add draft sensor carrier footprints and Step 3 handoff
    Confirm the version-one core logger scope selected by Saadat: Teensy 4.1,
    BNO055 #2472, MS8607 #4716, PA1616D #5440, onboard microSD, power control,
    status LEDs and supply monitoring. Record exclusions and retain unresolved
    battery, runtime, environmental and quantitative measurement requirements.
    Add the module connection map, per-header pin dispositions, I2C address and
    pull-up analysis, GPS UART mapping, power worksheet and mechanical review.
    Record that parts are not purchased and exact spreadsheet product numbers
    must be used. Identify the imported BNO055 footprint's QT/non-QT mismatch
    and regulator-output power pos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
    [footprint-check.kicad_pcb, step3-carrier-pad-map.csv]
2026-10-19 feat(hardware): add draft module symbols, Teensy carrier and assembly plan
    Add project-local symbols for BNO055 #2472 and MS8607 #4716 with default
    carrier footprints and explicit pin types, plus a logical-only PA1616D
    #5440 symbol with no footprint. Register the symbol library through
    sym-lib-table and scope LF line endings for it.
    Add the Teensy41_SSW_Carrier footprint, preserving the 48 imported pad
    identifiers/coordinates with candidate SSW-124 socket drills, F.Fab,
    courtyard, component keepout and USB/SD access allowances. Change both
    sensor carrier socket drills from 1.0 mm to the drawing-based 1.04 mm.
    Add MODULE_ASSEMBLY_PLAN.md (connector pairs, 12 mm separation, M2
    retention enve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
    [clear.kicad_pcb, component_inside.kicad_pcb, component_outside.kicad_pcb, footprint-check.kicad_pcb]
2026-10-19 docs(step4): add placement and interference plan and team-lead requests
    Add TEAM_LEAD_REQUESTS.md with a plain-language summary of Steps 1-3 and
    the inputs needed from the lead: Step 3 closure (R1-R5: module purchase or
    Adafruit #5440 drawing, enclosure, header/fastener approval, manufacturer),
    Step 4 placement assumptions (R6-R9: flight orientation, battery location,
    venting, LED visibility) and Step 5 inputs, with an answer log.
    Add PLACEMENT_AND_INTERFERENCE.md as the Step 4 draft: a floor plan on the
    legacy 97.79 mm outline (BNO055 top-left, MS8607 top-centre, GPS envelope
    top-right, Teensy bottom-left with microSD at the board edge, power region
    bottom-right), assumptions A1-A6, placem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
    [placement-fixture.kicad_pcb]
2026-10-19 feat(schematic): add Step 5 power architecture and draft v4 schematic
    Add POWER_ARCHITECTURE.md: legacy power findings F1-F6 (unswitched
    regulator outputs tied together, no USB/VIN isolation, LEDs without series
    resistors, monitor on regulated 5 V, no fuse or reverse protection), a
    planning load budget (about 175 mA typical / 260 mA peak at 5 V), and the
    architecture Saadat accepted: battery-agnostic 2-16 V input through PTC
    fuse, P-MOSFET reverse protection and an off-board panel switch into a
    Pololu S9V11F5 5 V buck-boost; Teensy 3.3 V to sensors through a ferrite;
    battery sense on pin 26; VUSB/VIN pads cut.
    Add Native_KiCad_v4/, a new schematic project generated from a documented
    connect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
    [PTERODACTYL_v4.kicad_sch, bom.csv, schematic-check.json]
2026-10-19 feat: add Step 6 v4 firmware and Step 7 placed v4 PCB
    Step 6: add Firmware_v4/PTERODACTYL_v4, a new logger written for the v4
    pins instead of porting v19.1 (which depends on u-blox UBX, XBee, OLED,
    LSM9DS1, MS5611 and the heater, and waits for input at startup). It starts
    logging automatically into numbered session folders with separate IMU
    (10 Hz), environment (1 Hz), GPS (per GGA), health (1 Hz) and event CSVs,
    each record carrying session, sequence, millis and status; missing data
    is written empty with a status, never stale. Adds a clean-stop switch,
    button/PBF markers, BNO055 reset recovery and status LEDs. Units follow
    V1_REQUIREMENTS (rad/s, Pa, m/s). sketch.yaml pins teensy:avr 1.62.0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
    [PTERODACTYL_v4.kicad_pcb, pcb-check.json]
2026-10-19 docs: add remaining-work checklist; record first autoroute attempt
    Add docs/REMAINING_WORK.md: a one-page progress table for Steps 1-10 and
    a to-do list by owner (team lead, Saadat, teammate, after modules arrive,
    before ordering), plus how to stay in sync with the generated files.
    Linked from the root README, docs index and CURRENT_STATUS.
    Prepare the v4 board for routing: Default/Power net classes (Power 0.5 mm
    for battery and supply nets) written to the project file by the schematic
    generator, and U2/U5 envelopes now keep out tracks and vias on the outer
    layers (PC10). Make the generator's unused-pin ordering deterministic
    (connections unchanged; ERC and netlist check still pass).
    Add t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
    [PTERODACTYL_v4.kicad_pcb, PTERODACTYL_v4.kicad_sch, pcb-check.json, schematic-check.json]
2026-10-19 feat(pcb): first-pass autoroute of the draft v4 board
    Route the v4 board with Freerouting 2.5.0 (portable .jar on an Eclipse
    Temurin JRE 25.0.4.1 zip, both SHA-256 verified; neither is installed or
    committed). Result: 192 track segments on F.Cu/B.Cu only and 10 vias;
    6 supply connections (SENSOR_3V3 decoupling and two +5V points) are left
    for hand routing.
    Routing setup changes:
    - Mark In1/In2 as power planes with a no-tracks rule area so the GND
    planes cannot be cut; vias may pass through.
    - Add a Supply3V3 net class (0.3 mm) for +3V3 and SENSOR_3V3; Power stays
    0.5 mm for the battery and +5V nets.
    - autoroute_v4_pcb.py exports a router-only DSN copy in a separate KiCad
    process: shri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
    [PTERODACTYL_v4.kicad_pcb, pcb-check.json]
2026-10-19 docs: publish v4 design review and validation evidence
    Record the independent review of saadat-dev source commit 8933189,
    including seven prioritized findings, concrete fixes and the completion
    assessment for development Steps 1-7.
    Document missing regulator/GPS footprints and open supply connections,
    sensor failure reporting, the unbounded BNO055 reset wait, incomplete SD
    session recovery, regulator startup voltage, stale GPS fields and the
    placement checker's dependence on generated geometry.
    Preserve fresh KiCad ERC, refilled DRC/parity, actual-board geometry
    inspection and Teensy firmware compilation evidence. Checks found zero
    ERC and enabled physical DRC violations, ten unconnected i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
2026-10-19 feat(pcb): integrate verified regulator carrier and draft GPS geometry
    Add the source-checked Pololu S9V11F5 three-pin carrier, update U2 symbol/net contracts, and replace its PCB envelope while preserving all existing placement and routing. Record official dimension and drill evidence.
    Add a clearly unverified legacy GPS comparison footprint without assigning U5. Keep current #5440 geometry, installed fit, retention and fabrication approval open.
    Measure placement from the live PCB and add source-coordinate, symbol/pad, native fixture, netlist and movement-regression checks. Publish validation evidence and teammate resume notes: zero ERC/enabled physical DRC violations, U5 missing, and 12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
    [PTERODACTYL_v4.kicad_pcb, PTERODACTYL_v4.kicad_sch, footprint-fixture.kicad_pcb, reg20a-drill.dxf]
2026-10-19 feat(pcb): complete power routing for placed v4 modules
    Connect regulator VIN/VOUT, the 5 V rail and SENSOR_3V3 decoupling/test points. Move TP1 and TP2 beside the power section and TP4 beside the sensor rail; remove the 68.667 mm unloaded TP1 spur. Add 37 outer-layer power segments without new vias.
    Preserve 197 existing track/via objects and 47 footprint placements, with only three test points relocated. Keep schematic, symbol contracts, net classes and design rules unchanged. Refill inner GND planes and publish copper/return-plane views plus semantic preservation evidence.
    Native checks report zero enabled physical DRC violations and zero unconnected items for the 50 placed footprints.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
    [PTERODACTYL_v4.kicad_pcb]
2026-10-20 fix(pcb): improve ADC filtering layout and I2C routing order
    Move C2 within 4.493 mm of Teensy carrier pin 26, relocate TP3/TP5 and adjust only the local 3V3/button routes needed for clearance. Replace the old remote capacitor branch.
    Route the I2C host leg through MS8607 before BNO055, with SDA/SCL lengths of 135.163/128.209 mm. Add four signal vias and three nearby GND stitching vias connected to both inner planes. Preserve 220 existing copper objects and 47 footprint placements.
    Place readable silkscreen references, module/control names, battery polarity and a test-point key. Add native validation for I2C graph order, ADC proximity, plane connections and existing placement/width rules;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
    [PTERODACTYL_v4.kicad_pcb]
2026-10-20 docs: prepare teammate meeting handoff and reconcile current status
    Organize completed deliverables, remaining GPS/power/firmware/mechanical work, lead inputs, validation equipment, proposed owners, a meeting agenda and an unassigned decision log for October 20.
    Replace stale remaining-work counts and correct lead-request descriptions of regulator integration, present-footprint routing and startup voltage. Link the current layout evidence and mark earlier exports as historical. Preserve explicit GPS, fabrication and hardware-test gates; no design or firmware changes.
2026-10-20 fix(firmware): recover SD sessions and bound BNO055 reset waits
    Require all five CSV headers and metadata to open, write and sync before
    activating a logging session. Use Teensy's FsFile interface to check write,
    sync and close failures; invalidate and close failed sessions, remount after
    a five-second pause, and create a fresh exclusive S000-S999 folder. Preserve
    partial logs and refuse reuse when the session namespace is exhausted.
    Keep file/storage fault counters across session recovery, append
    storage_fault_total to health/USB diagnostics, and latch the fault LED.
    Replace the premature CLEAN_STOP event with STOP_REQUEST and report the
    checked close result over USB. Keep logging stopped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
    [PTERODACTYL_v4.ino, config.h, metadata.cpp, reliability_test.cpp]
2026-10-20 fix(firmware): propagate sensor transfer and CRC failures into logs
    Add checked BNO055 quaternion, vector and calibration getters, preserving
    caller output on transfer failure. Check initialization and external-crystal
    configuration writes. Use the checked getters in the logger and emit empty
    READ_FAIL rows if any required transfer fails.
    Vendor Adafruit MS8607 1.0.4 with its original license and attribution.
    Propagate reset, PROM/configuration, temperature/pressure conversion and
    ADC/humidity transfer failures, including the existing PROM and humidity CRC
    checks. Clear requested output events before reading and publish them only
    after all requested reads succeed. Return failures through Un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
    [PTERODACTYL_v4.ino, config.h, reliability_test.cpp, test_firmware_reliability.py]
2026-10-21 feat(pcb): finalize P1 fabrication and assembly release
    [PTERODACTYL_v4-B_Cu.gbl, PTERODACTYL_v4-B_Mask.gbs, PTERODACTYL_v4-B_Silkscreen.gbo, PTERODACTYL_v4-Edge_Cuts.gm1, PTERODACTYL_v4-F_Cu.gtl, PTERODACTYL_v4-F_Mask.gts, PTERODACTYL_v4-F_Silkscreen.gto, PTERODACTYL_v4-NPTH.drl]
2026-10-21 feat(mechanical): add open PCB bench holder CAD
    [Holder-with-reference-PCB.step, Pterodactyl-holder.step, Pterodactyl-holder.stl]
2026-10-21 feat(pcb): add team names to back silkscreen
    [PTERODACTYL_v4-B_Cu.gbl, PTERODACTYL_v4-B_Mask.gbs, PTERODACTYL_v4-B_Silkscreen.gbo, PTERODACTYL_v4-Edge_Cuts.gm1, PTERODACTYL_v4-F_Cu.gtl, PTERODACTYL_v4-F_Mask.gts, PTERODACTYL_v4-F_Silkscreen.gto, PTERODACTYL_v4-job.gbrjob]
