mahruschow/team-pterodactyl/(notices)

Notices in the files:
parts and their libraries:
UNVERIFIED product 5440 fit. Derived from legacy Adafruit PA6H CAD 70430c1; CC BY-SA 3.0, Adafruit Industries/Limor Fried. Do not assign to production schematic until M01 closes.
